eSpark-Backup/nabilfesal-efi-hw/README.md

# Earth Fault Indicator
#### Client Name: Nabil Fesal
