eSpark-Backup/nabilfesal-efi-hw/Design Files/EFI_Main_Board-V1.10/Deliverables/Renderings/3D-BottomView.png

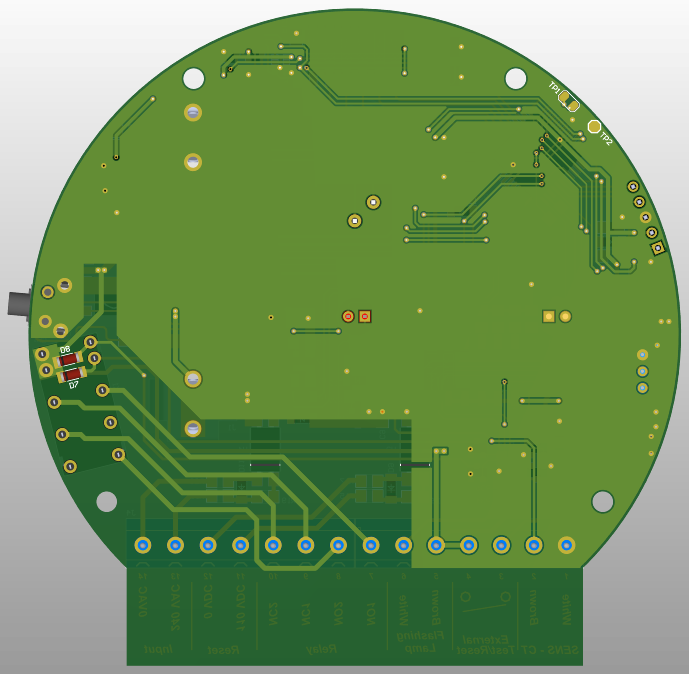
Design Files/EFI_Main_Board-V1.10/Deliverables/Renderings/3D-BottomView.png
