eSpark-Backup/nabilfesal-efi-hw/pics/Prototype/EFI_Main_Board-V1 (5).JPG

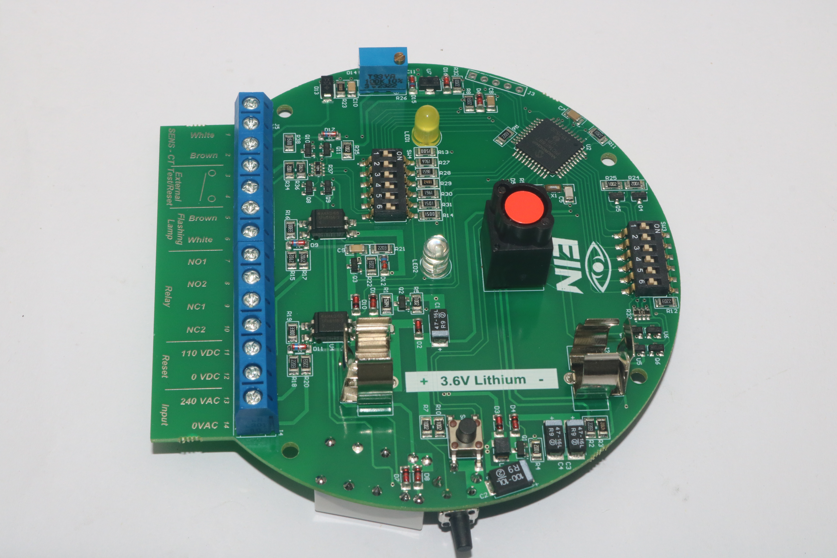
pics/Prototype/EFI_Main_Board-V1 (5).JPG
