eSpark-Backup/nabilfesal-efi-hw/pics/Prototype/EFI_Main_Board-V1 (6).JPG

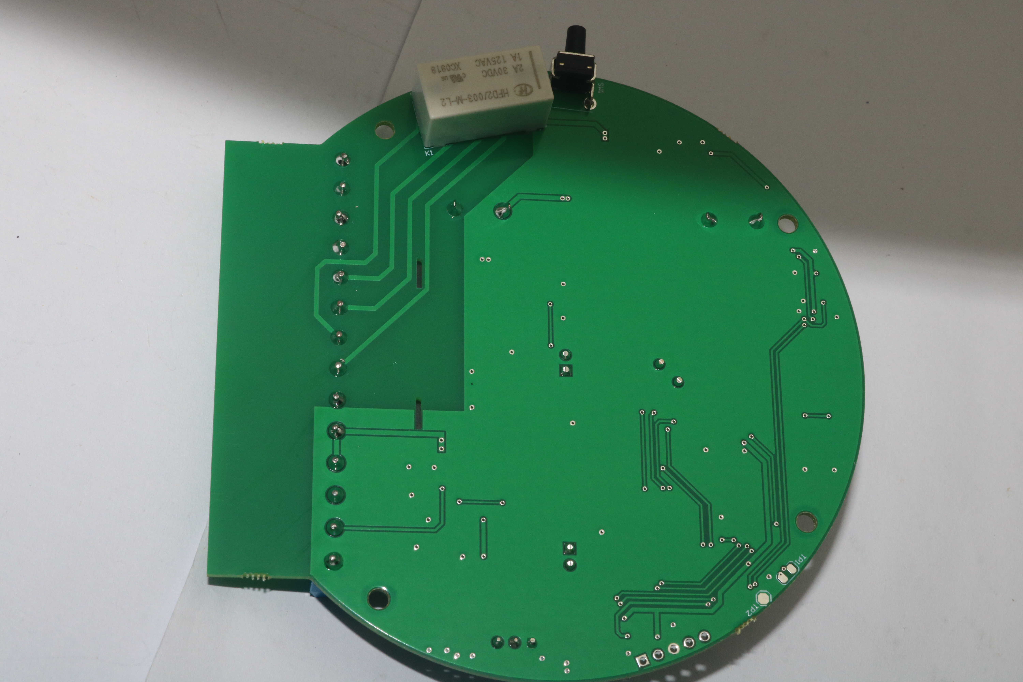
pics/Prototype/EFI_Main_Board-V1 (6).JPG
