eSpark-Backup/nabilfesal-efi-hw/pics/Prototype/EFI_Main_Board-V1 (10).JPG

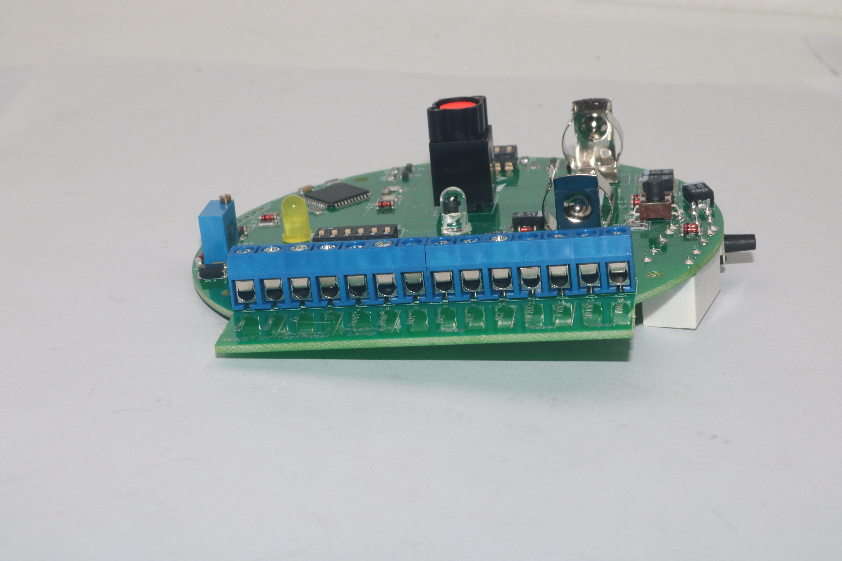
pics/Prototype/EFI_Main_Board-V1 (10).JPG
