eSpark-Backup/nabilfesal-efi-hw/Design Files/EFI_Main_Board-V1.10/BOM/Client_BOM_EFI_Main_Board-V1.10.xlsx

# | Item Type | Designator | Description | Footprint | Manufacturer Part Number | Manufacturer | Value | Quantity | Remarks
1 | Capacitors | C1, C3, C4 | CAP TANT 47UF 10% 16V 2312 | Case-C | 293D476X9016C2TE3 | Vishay Sprague | 47uF | 3
2 | Capacitors | C2 | CAP TANT 100UF 10% 10V 2917 | Case-D | 293D107X9010D2TE3 | Vishay Sprague | 100uF | 1
3 | Capacitors | C5, C6 | CAP CER 15PF 50V C0G/NPO 1206 | Cap-1206 | CC1206JRNPO9BN150 | Yageo | 15pF | 2
4 | Capacitor | C7, C8 | CAP CER 0.1UF 50V X7R 1206 | Cap-1206 | CC1206KRX7R9BB104 | Yageo | 0.1uF | 2
5 | Capacitor | C9, C10, C11 | CAP CER 0.047UF 100V X7R 1206 | Cap-1206 | CC1206JRX7R0BB473 | Yageo | 0.047uF | 3
6 | Schottky Diodes | D1, D2, D3, D4, D5, D6, D10, D16 | DIODE SCHOTTKY 40V 200MA SOD80 | LL-34 | LL103A-GS08 | Vishay | - | 8
7 | Diode | D7, D8 | 100V 1V@50mA 4ns 300mA LL-34 Switching Diodes ROHS | LL-34 | LL4148 | Yangzhou Yangjie Elec Tech | - | 2
8 | Diode | D9, D11 | Independent Type 2.5V~2.9V 500mW 2.7V LL-34 Zener Diodes ROHS | LL-34 | ZMM2V7 | HXY MOSFET | - | 2
9 | Diode | D12, D17 | Independent Type 500mW 3.4V~3.8V 3.6V LL-34 Zener Diodes ROHS | LL-34 | ZMM3V6 | HXY MOSFET | - | 2
10 | TVS Diodes | D13 | TVS DIODE 110VWM 177VC DO214AC | SMA Bi Directional | SMAJ110CA-E3/5A | Vishay | - | 1
11 | Rectifier Diodes | D14 | DIODE STANDARD 75V 150MA SOD80C | LL-34 | LL4448-GS08 | Vishay | - | 1
12 | Diode | D15 | Independent 4.8V~5.4V 500mW 5.1V LL-34 Single Zener Diodes RoHS | LL-34 | ZMM5V1 | HXY MOSFET | - | 1
13 | Battery Holder | J1, J2 | BATTERY CONTACT CLIP AA PC PIN | BK-92 | BK-92 | Memory Protection Devices | - | 2
14 | Screw Terminal | J4, J5 | 1x7P -40℃~+105℃ 15A 300V Blue 12~24 Direct Insert 5mm 1 7 Plugin,P=5mm Screw Terminal Blocks ROHS | Custom | JL301-50007U02 | JILN | - | 2
15 | Relay | K1 | Magnetic Latching Relays ROHS | Custom | AZ832P2-2C-3DE | ZETTLER | - | 1
16 | Inductors | L1 | FIXED IND 100UH 40MA 10 OHM SMD | Custom | NLV32T-101J-EF | TDK | 100uH | 1
17 | Magnetic Flag Indicator | L2 | Magnetic Status Indicator | Custom | 30NR | Flip Dots | 30NR | 1 | This part will be sourced from a custom supplier
18 | LED | LED1 | LED YELLOW DIFFUSED 5MM T/H | TH LED 5mm Yellow | 333-2UYD/S530-A3-L | Everlight | - | 1
19 | LEDs | LED2 | LED RED CLEAR 5MM ROUND T/H | TH LED 5mm_ | 333-2SURC/S530-A3 | Everlight | - | 1
20 | MOSFETs | Q1, Q2, Q6, Q7, Q8, Q9, Q10, Q11 | MOSFET BVDSS: 8V~24V SOT23 T&R 3 | SOT-23 | DMG3420UQ-7 | Diodes | - | 8
21 | BJTs | Q3 | TRANS NPN 45V 0.1A TO-236AB | SOT-23 | BC847C,215 | Nexperia | - | 1
22 | Transistors | Q4, Q5 | TRANS NPN 65V 0.1A SOT23-3 | SOT-23 | BC846B-7-F | Diodes | - | 2
23 | Resistors | R1 | RES SMD 60.4 OHM 1% 1/4W 1206 | Res-1206 | AC1206FR-0760R4L | Yageo | 60.4R | 1
24 | Resistors | R2, R6, R8, R9, R11, R12, R18, R20, R21, R22, R32 | RES SMD 220K OHM 0.1% 1/4W 1206 | Res-1206 | RT1206BRD07220KL | Yageo | 220K | 11
25 | Resistor | R3 | 250mW Thin Film Resistor 200V ±25ppm/℃ ±0.1% 47kΩ 1206 Chip Resistor - Surface Mount ROHS | Res-1206 | ARG06BTC4702 | Viking Tech | 47K | 1
26 | Resistors | R4, R5, R7, R10, R24, R25, R34, R35 | RES 10K OHM 1% 1/2W 1206 | Res-1206 | AC1206FR-7W10KL | Yageo | 10K | 8
27 | Resistor | R13, R14, R38 | 250mW Thick Film Resistors 200V ±100ppm/℃ ±1% 150Ω 1206 Chip Resistor - Surface Mount ROHS | Res-1206 | FRC1206F1500TS | FOJAN | 150R | 3
28 | Resistor | R15, R17 | 250mW Thick Film Resistors 200V ±100ppm/℃ ±1% 27kΩ 1206 Chip Resistor - Surface Mount ROHS | Res-1206 | FRC1206F2702TS | FOJAN | 27K | 2
29 | Resistor | R16, R19 | 250mW Thick Film Resistors 200V ±100ppm/℃ ±1% 330Ω 1206 Chip Resistor - Surface Mount ROHS | Res-1206 | FRC1206F3300TS | FOJAN | 330R | 2
30 | Resistors | R23 | RES SMD 22K OHM 0.1% 1/4W 1206 | Res-1206 | RT1206BRD0722KL | Yageo Group | 22K | 1
31 | Potensiometer | R26 | TRIMMER 100K OHM 0.5W PC PIN TOP | Custom | T93YA104KT20 | Vishay Sfernice | 100K | 1
32 | Resistors | R27 | RES SMD 5.62K OHM 0.1% 1/4W 1206 | Res-1206 | RT1206BRD075K62L | Yageo Group | 5.62K | 1
33 | Resistors | R28 | RES SMD 2.4K OHM 0.1% 1/4W 1206 | Res-1206 | RT1206BRD072K4L | Yageo Group | 2.4K | 1
34 | Resistors | R29 | RES SMD 1.54K OHM 0.1% 1/4W 1206 | Res-1206 | RT1206BRD071K54L | Yageo Group | 1.54K | 1
35 | Resistors | R30 | RES SMD 1.15K OHM 0.1% 1/4W 1206 | Res-1206 | RT1206BRD071K15L | Yageo Group | 1.15K | 1
36 | Resistors | R31 | RES 800 OHM 0.1% 1/4W 1206 | Res-1206 | MCA12060D8000BP500 | Vishay | 800R | 1
37 | Resistor | R33 | 4 ±5% 10kΩ 62.5mW ±200ppm/℃ 0603x4 Resistor Networks, Arrays ROHS | 0603x4 | 4D03WGJ0103T5E | Royal Electronic Factory | 10K | 1
38 | Resistor | R36 | 250mW Thick Film Resistors 200V ±100ppm/℃ ±1% 47Ω 1206 Chip Resistor - Surface Mount ROHS | Res-1206 | FRC1206F47R0TS | FOJAN | 47R | 1
39 | Resistor | R37 | RES ARRAY 4 RES 100K OHM 1206 | Custom | YC164-JR-07100KL | Yageo | 100K | 1
40 | Tactile Switch | SW1 | 50mA Lying SPST 24V Plugin Tactile Switches ROHS | Custom | 1825027-8 | TE Connectivity | - | 1
41 | Switches | SW2 | SWITCH TACTILE SPST-NO 0.05A 24V | Custom | FSM6JSMATR | TE Connectivity Alcoswitch | - | 1
42 | DIP SWITCH | SW3, SW4 | 6 digits 24V Black 25mA 3000 Times SMD DIP Switches ROHS | Custom | SMXS-06K-TP | SM Switch | - | 2
43 | IC | U1 | Supervisory Circuits | SOT-89-3 | XC61CC2502PR-G | Torex | - | 1
44 | IC | U2 | IC MCU 8BIT 14KB FLASH 44TQFP | 44-TQFP (10x10) | PIC16F887-I/PT | Microchip | - | 1
45 | IC | U3, U4 | OPTOISOLATOR 5.3KV TRANS 4SMD | Custom | SFH6156-2 | Vishay | - | 2
46 | MOSFETs | U5, U6 | MOSFET P-CH 20V 4.2A SOT23-3 | SOT-23 | DMP2305U-7 | Diodes Zetex | - | 2
47 | IC | U7 | Supervisory Circuits | SOT-89-3 | XC61CC3002PR-G | Torex | - | 1
48 | Crystals | X1 | 32.768kHz Surface Mount Crystal 12.5pF ±20ppm SMD3215-2P Crystals ROHS | SMD3215-2P | Q13FC13500004 | Epson | - | 1
49 | Peripheral | Battery | BATTERY LITHIUM 3.6V AA | Custom | LS14500 | Saft | - | 1
50 | Peripheral | CT | Split core Ground fault protection current transformer | Custom | LO-CTK1503203 | WUXI LIOU ELECTRONICS CO.,LTD | - | 1 | This part will be sourced from a custom supplier
