eSpark-Backup/nabilfesal-efi-hw/Design Files/EFI_Main_Board-V1.10/Deliverables/Supporting Files/EFI.step

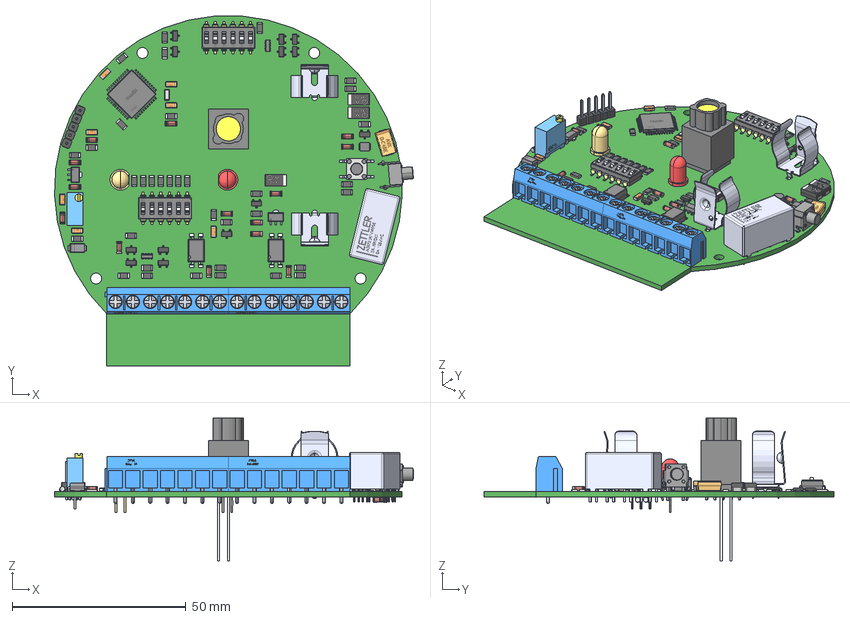
[picture p17: CAD file, 2025-08-29]
Design Files/EFI_Main_Board-V1.10/Deliverables/Supporting Files/EFI.step
103.3 x 100.7 x 41.0 mm
FSM6JSMATR--3DModel-STEP-510211
User Library-LED-D5R
30nr status indicator
User Library-NDK_NX3215SA
User_Library_SOT89_5005 x 2
CircuitWorks-SOT-23 x 13
c-1825027-8-h-3d_RGB6710886
User Library-CR3216-1206 x 35
YC164-JR-070RL
TC164-JR-070RL
User Library-LED-D5R_RGB6740479
AZ832P2-2C-3DE
CircuitWorks-HEADER 2_54 VERTICAL 5X
BK-92 x 2
User Library-DO-214AC SMA
User Library-1206 SMD Capacitor x 7
C-CASE x 3
User Library-AVX_D_CASE
