eSpark-Backup/nabilfesal-efi-hw/Enclosure-Files/Fault Indicator Ard - X-20251015T050849Z-1-001/Fault Indicator Ard - X/Fault Indicator Ard - X V1.1 220925/Fault Indicator Ard - X CAD Model 220925/Fault Indicator Ard-X_22092025 3D CAD Model.STEP

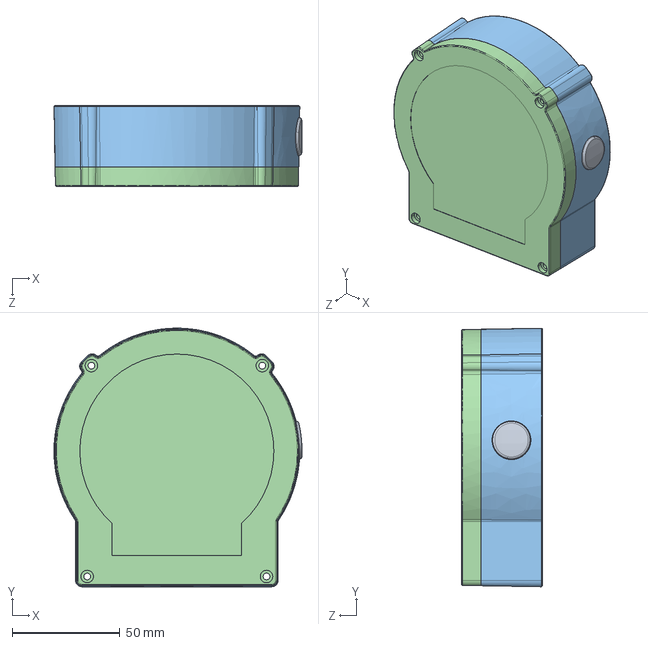
[picture p18: CAD file, 2025-10-16]
Enclosure-Files/Fault Indicator Ard - X-20251015T050849Z-1-001/Fault Indicator Ard - X/Fault Indicator Ard - X V1.1 220925/Fault Indicator Ard - X CAD Model 220925/Fault Indicator Ard-X_22092025 3D C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
115.0 x 119.9 x 37.4 mm
