eSpark-Backup/nabilfesal-efi-hw/(list of files, cad)

Other CAD files:
Design Files/EFI_Main_Board-V1.00/Deliverables/Supporting Files/EFI.step
Design Files/EFI_Main_Board-V1.00/Deliverables/Supporting Files/EFI.DWG
Design Files/EFI_Main_Board-V1.00/Deliverables/Supporting Files/EFI.DXF
Design Files/EFI_Main_Board-V1.10/Deliverables/Supporting Files/EFI.DWG
Design Files/EFI_Main_Board-V1.10/Deliverables/Supporting Files/EFI.DXF
