eSpark-Backup/nabilfesal-efi-hw/Design Files/EFI_Main_Board-V1.10/Schematics/EFI_Main_Board-V1.10.pdf

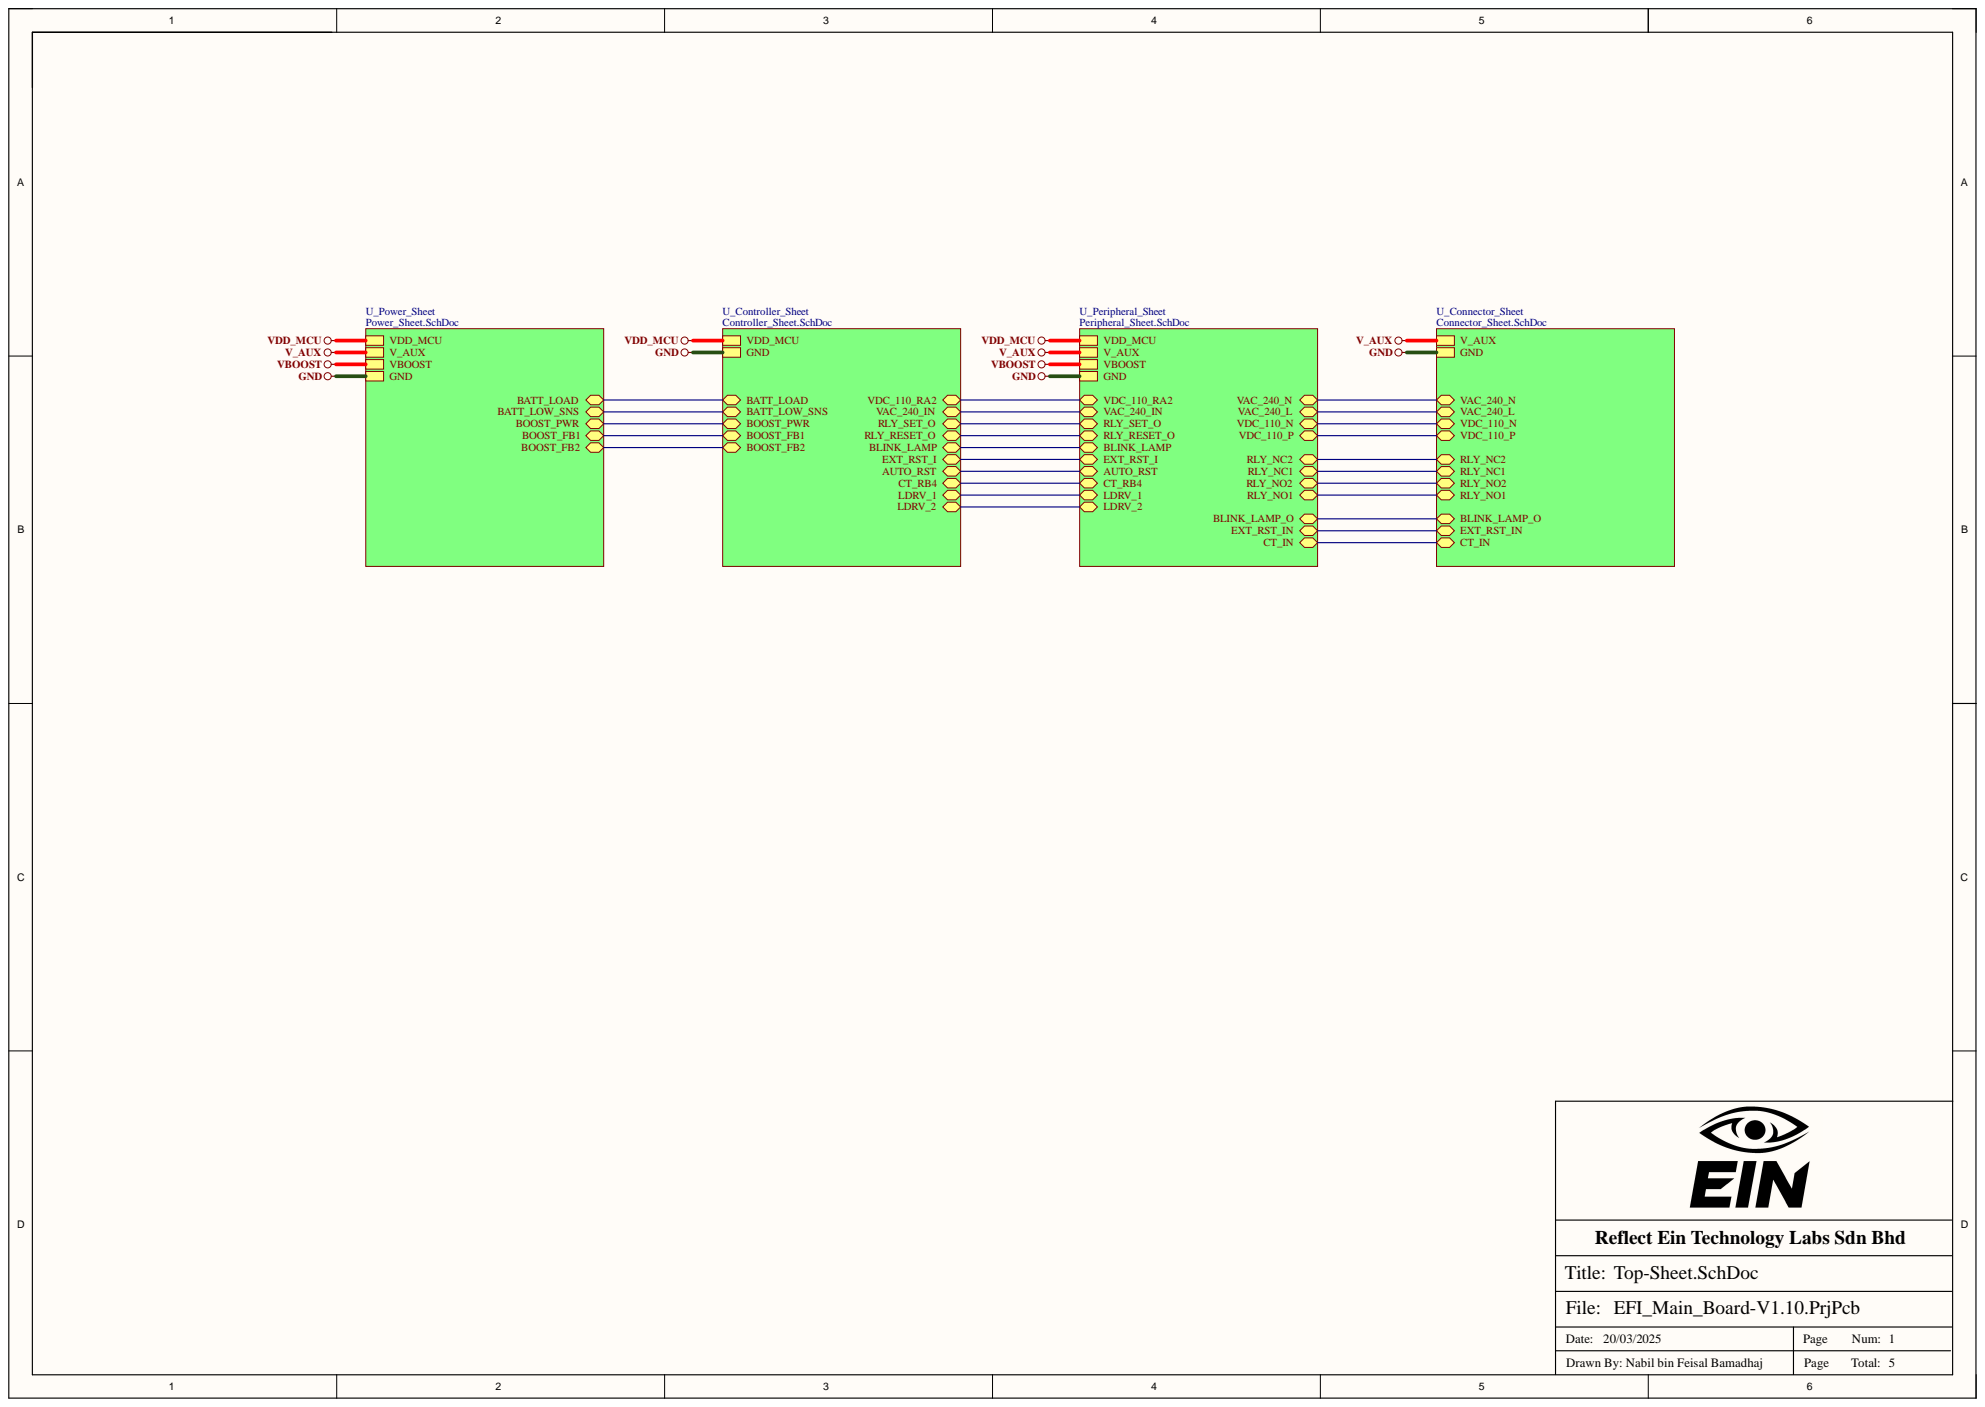
[picture p19: page 1]

Reflect Ein Technology Labs Sdn Bhd

Date: 20/03/2025 | Page Num: 1

Drawn By: Nabil bin Feisal Bamadhaj | Total:

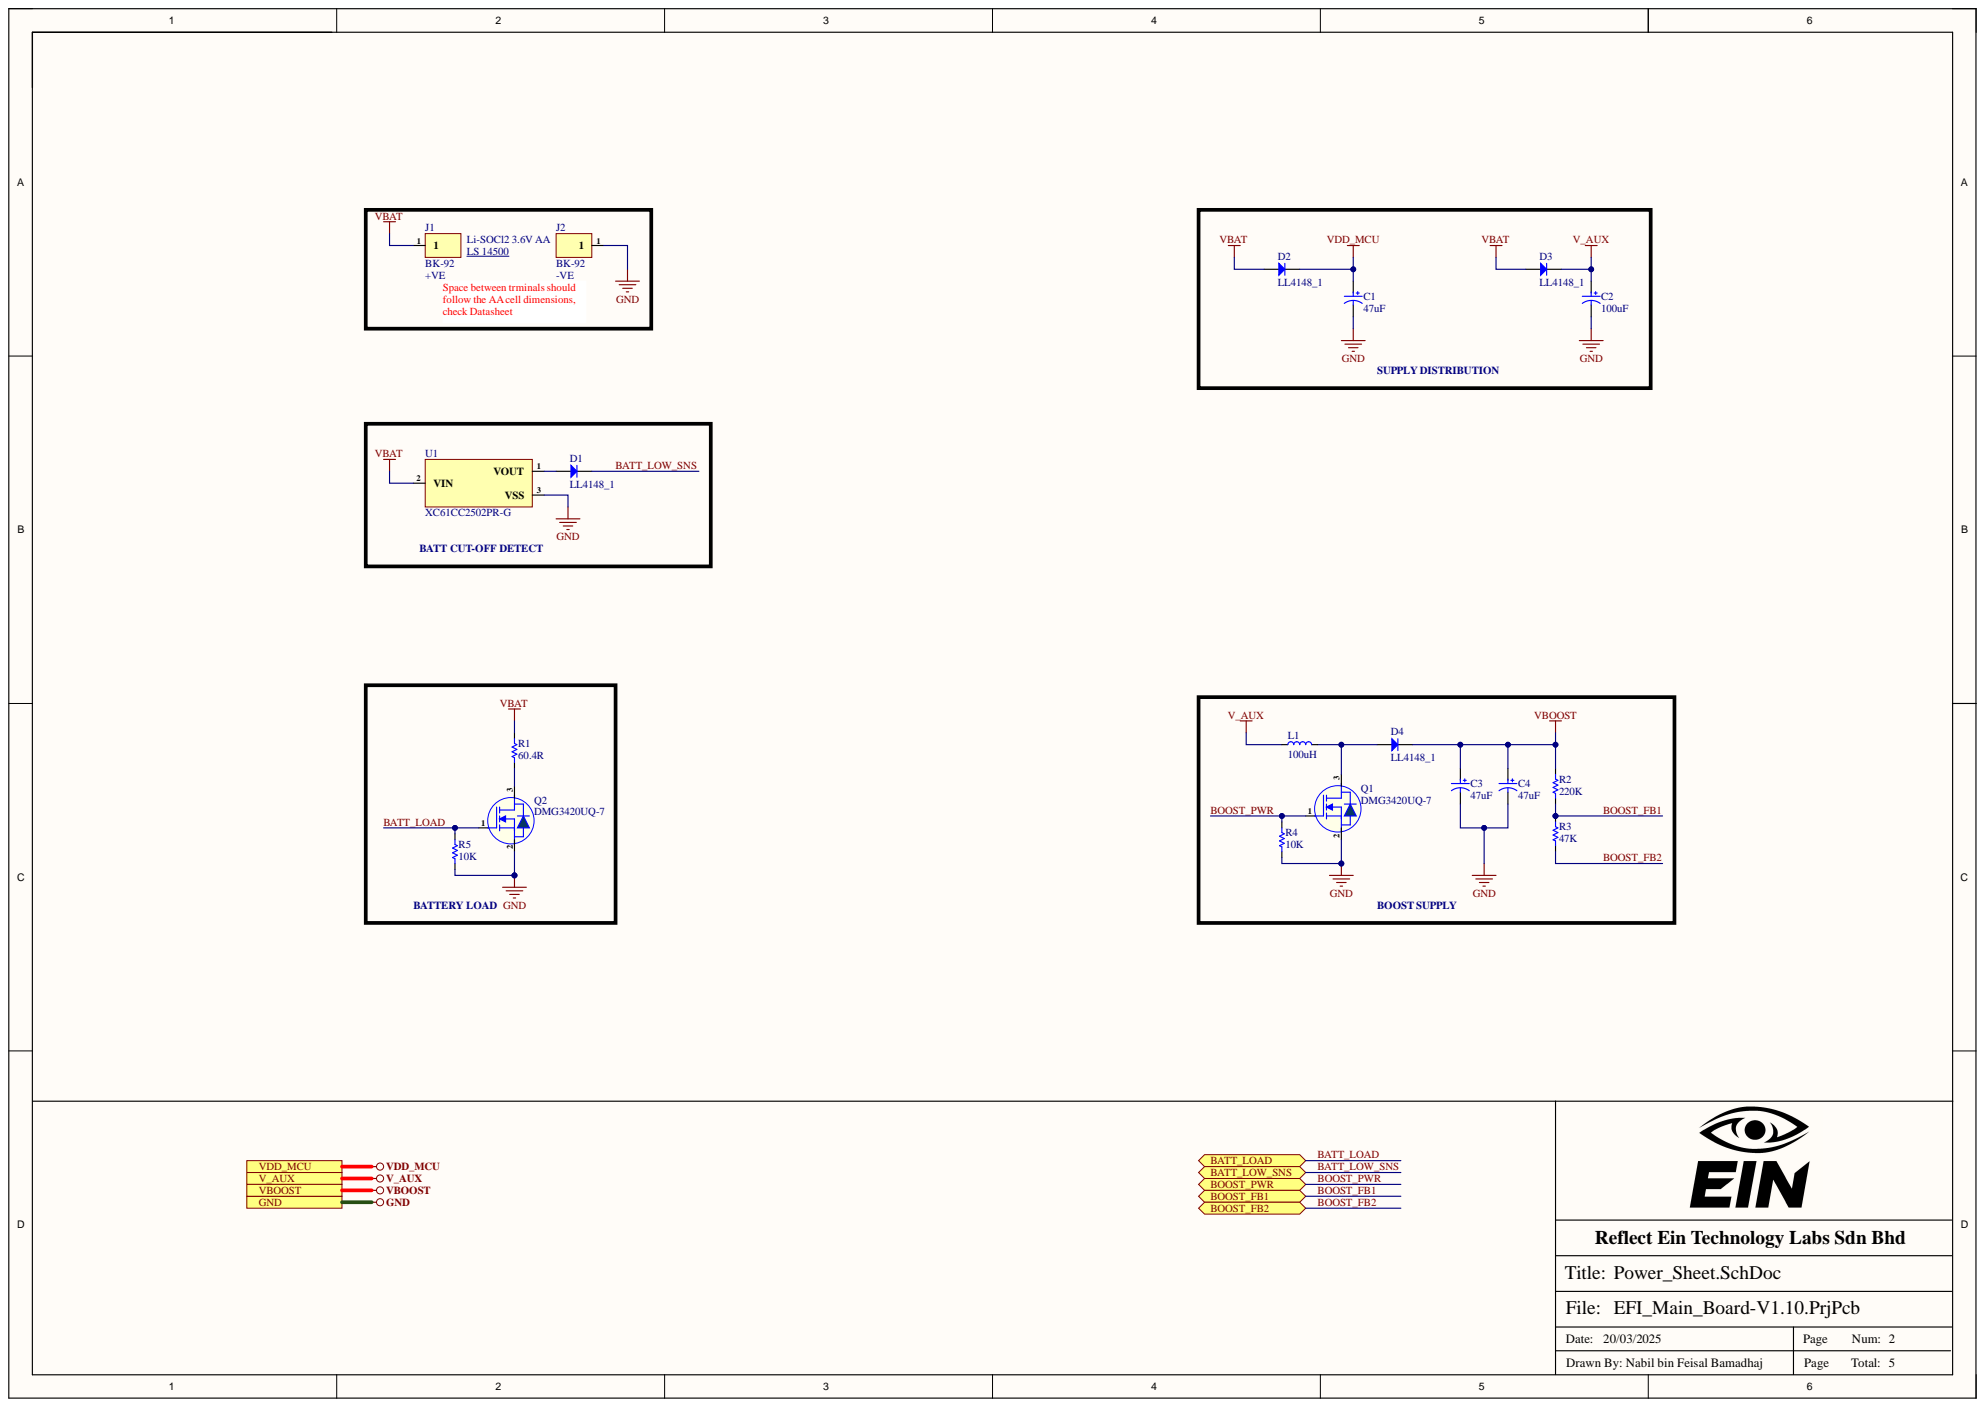
[picture p20: page 2]

Space between trminals should
follow the AAcell dimensions,
check Datasheet

BATT CUT-OFF DETECT

Reflect Ein Technology Labs Sdn Bhd

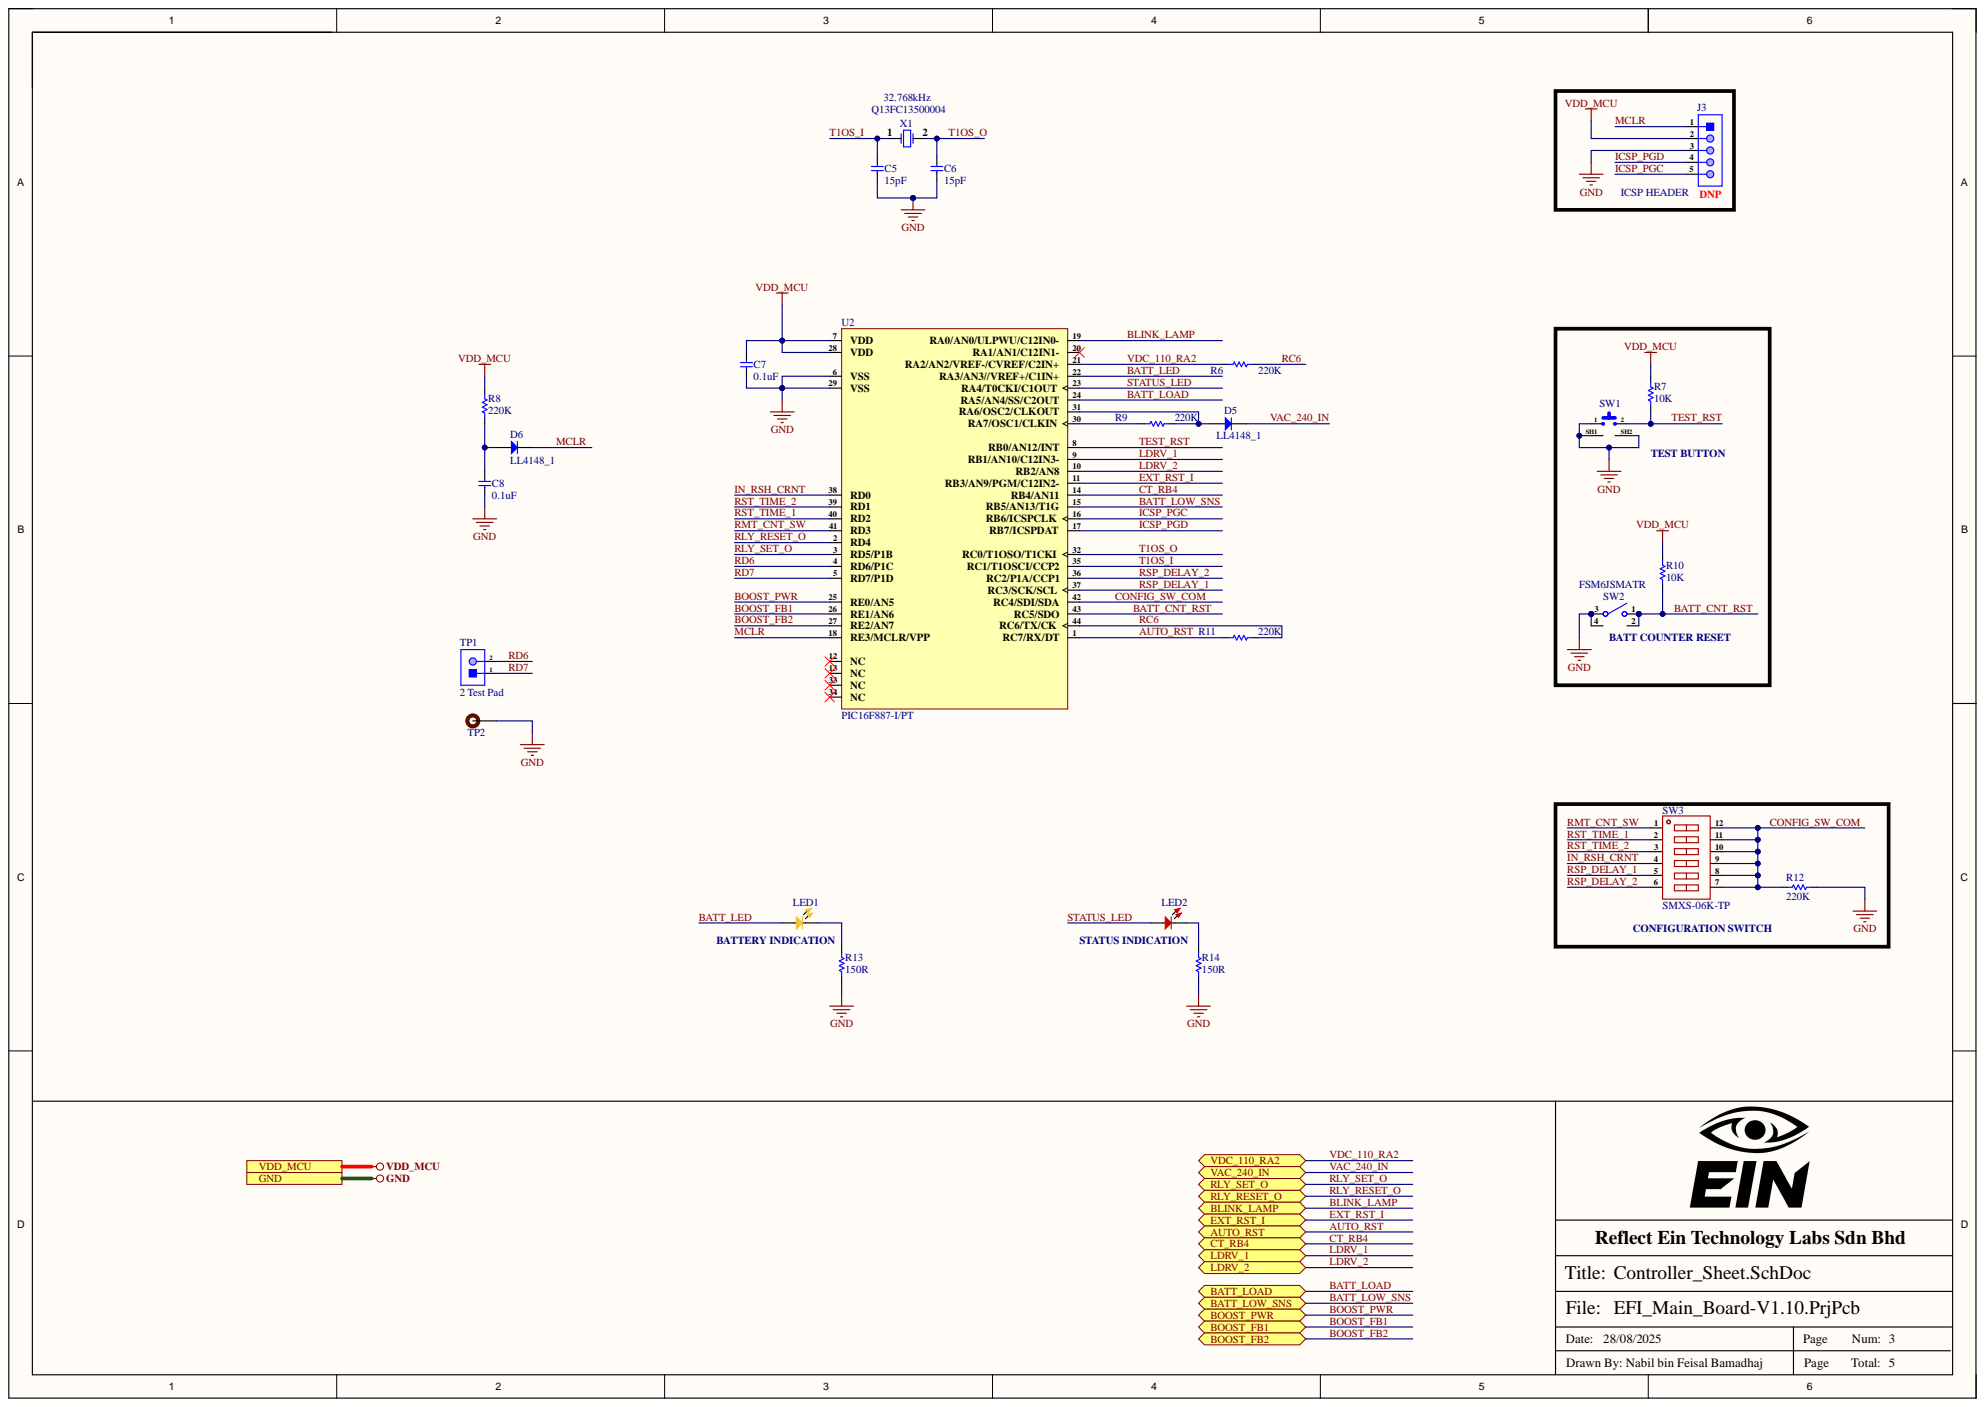
[picture p21: page 3]

Reflect Ein Technology Labs Sdn Bhd

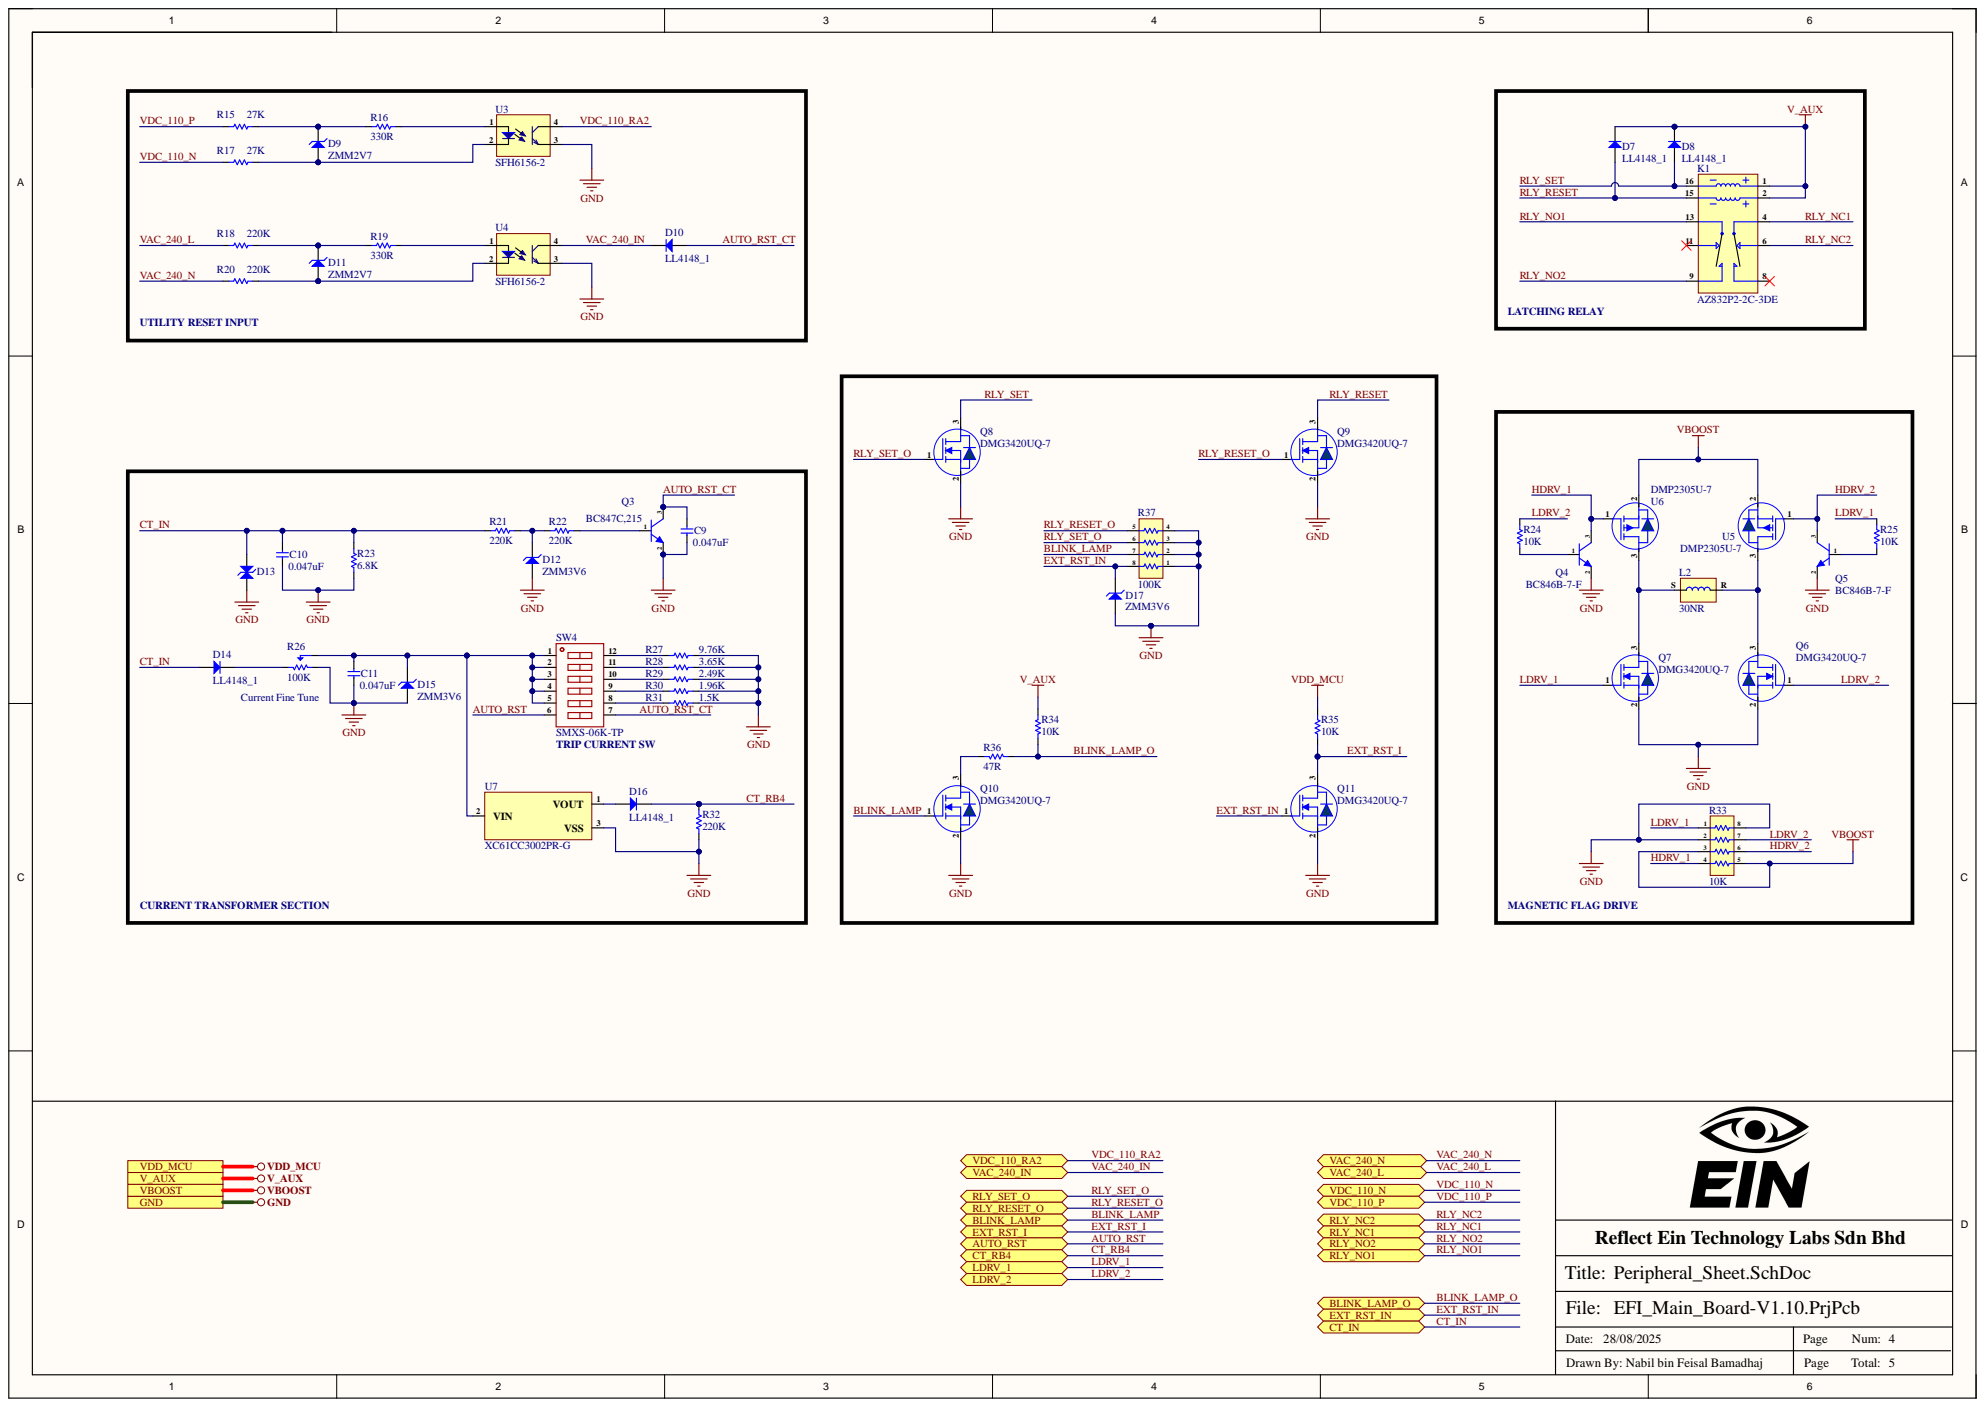
[picture p22: page 4]

3 6 | HDRV_2

HDRV_1

Reflect Ein Technology Labs Sdn Bhd

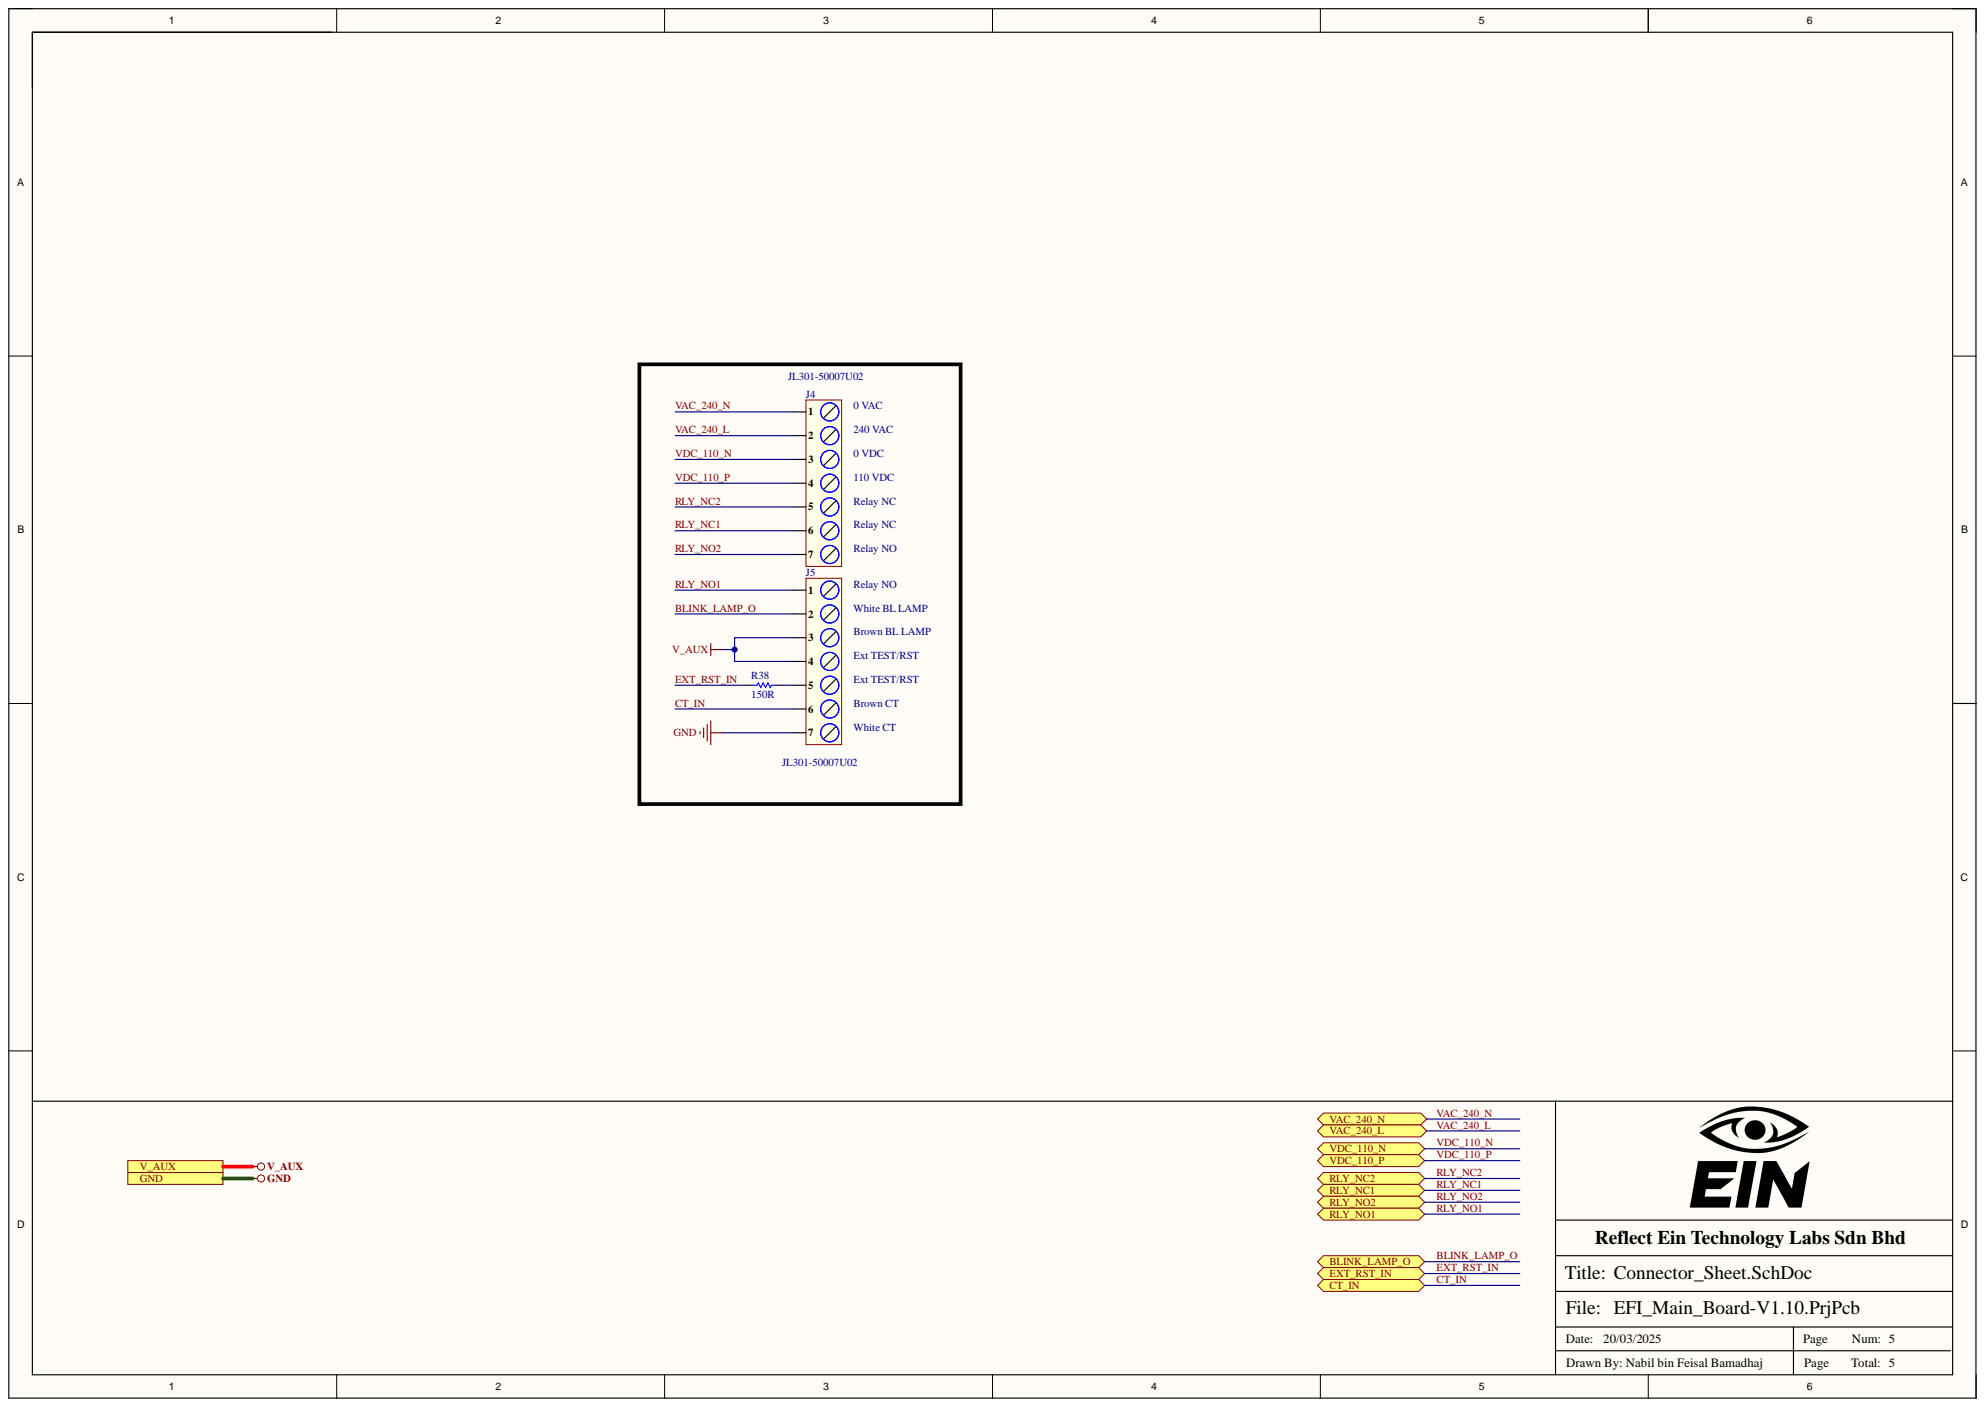
[picture p23: page 5]

Reflect Ein Technology Labs Sdn Bhd
