eSpark-Backup/nabilfesal-efi-hw/Design Files/EFI_Main_Board-V1.00/Schematics/EFI_Main_Board-V1.00.pdf

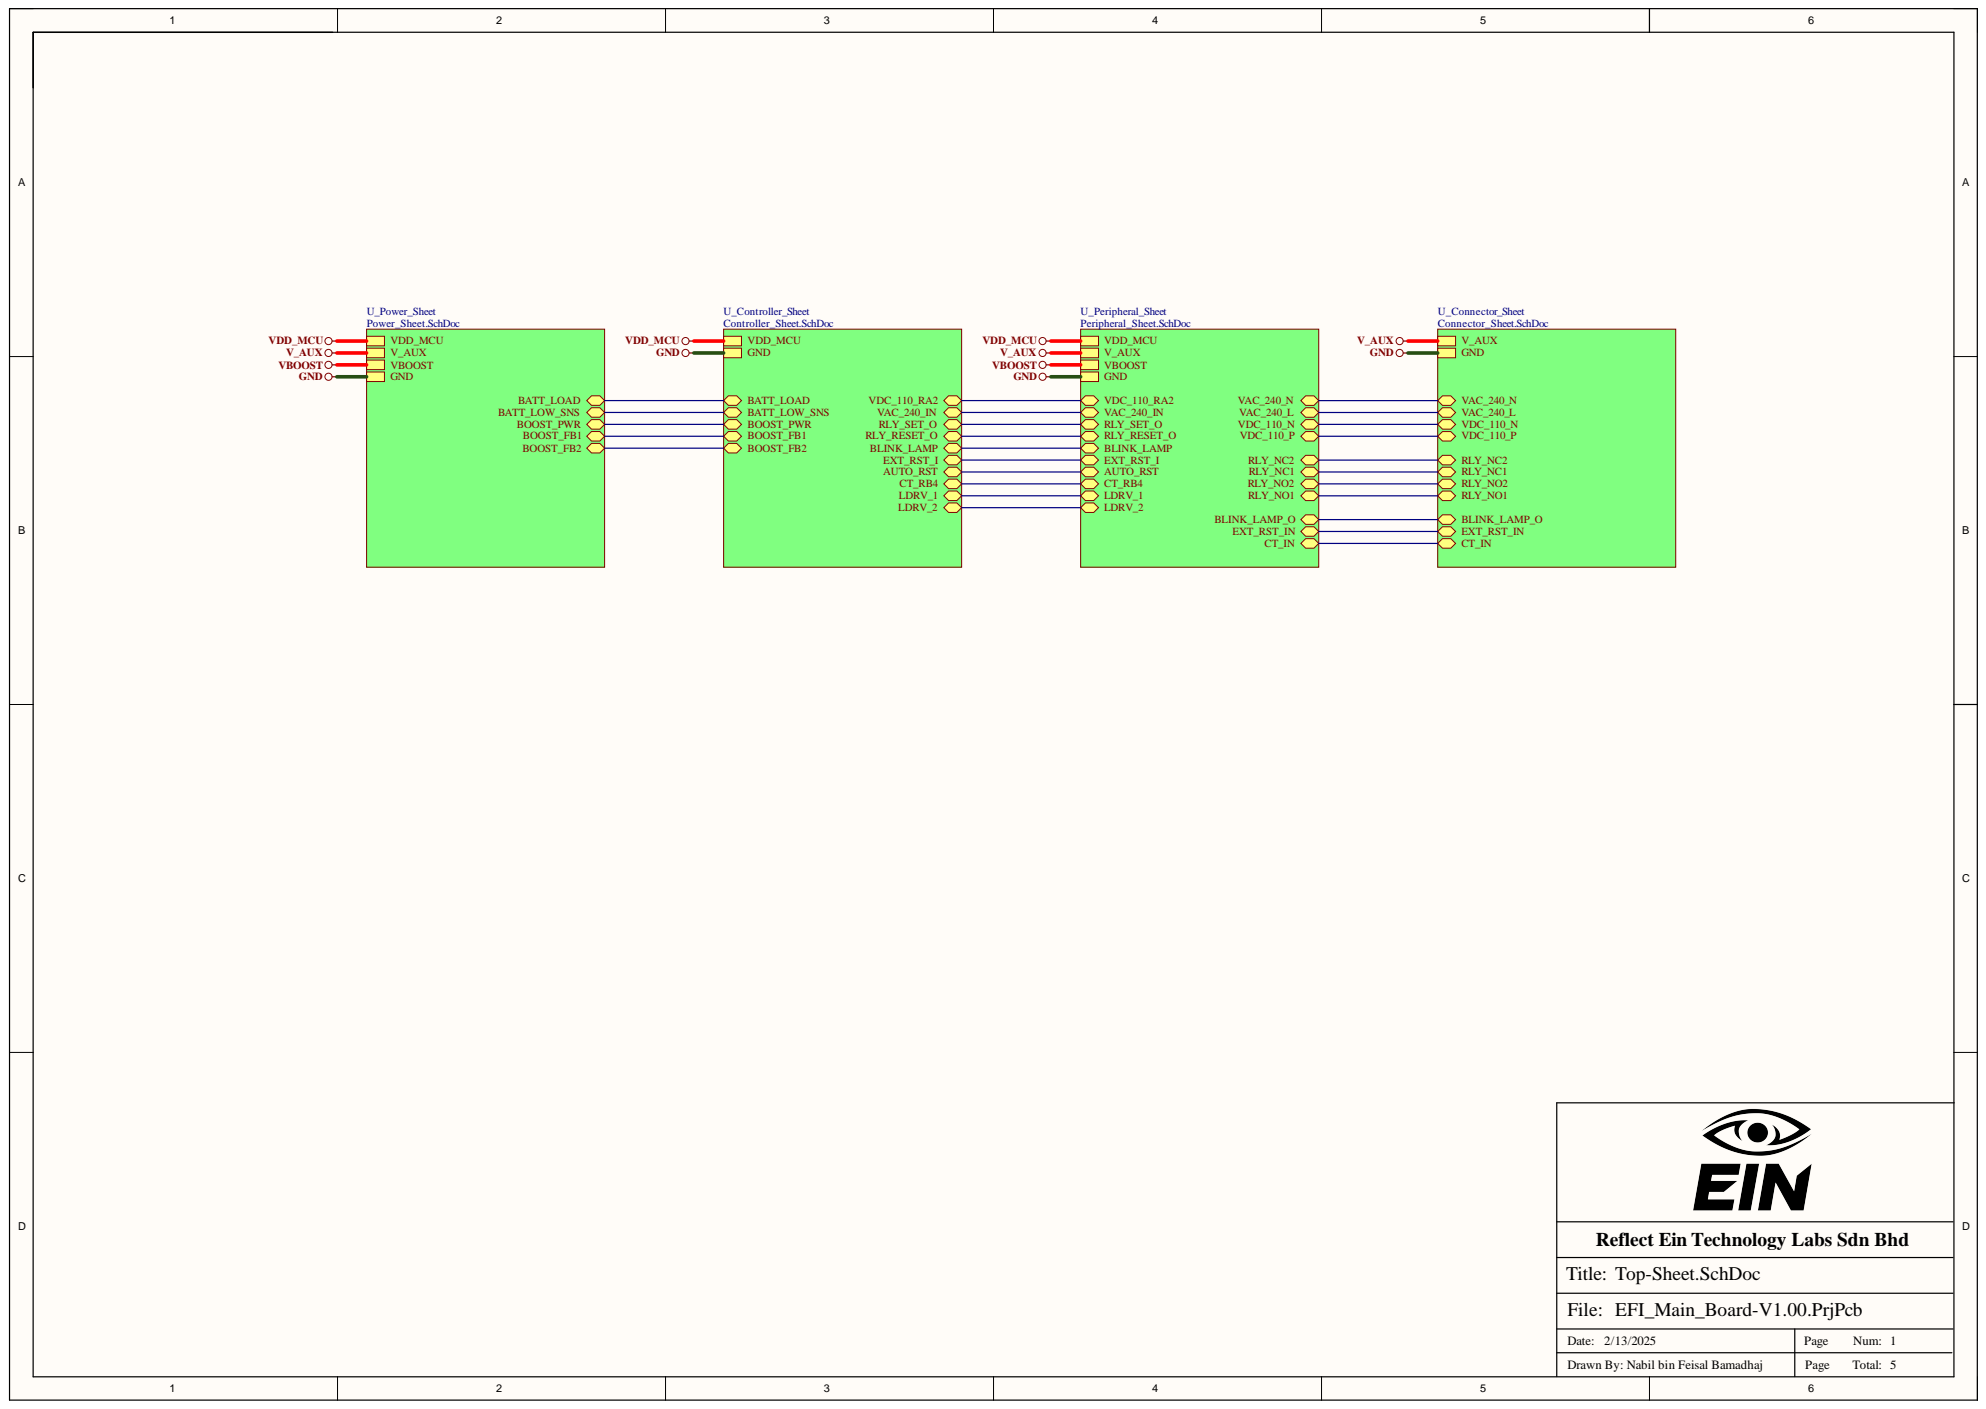
[picture p24: page 1]

Reflect Ein Technology Labs Sdn Bhd

Date: 2/13/2025 | Page Num: 1

Drawn By: Nabil bin Feisal Bamadhaj | Page Total:

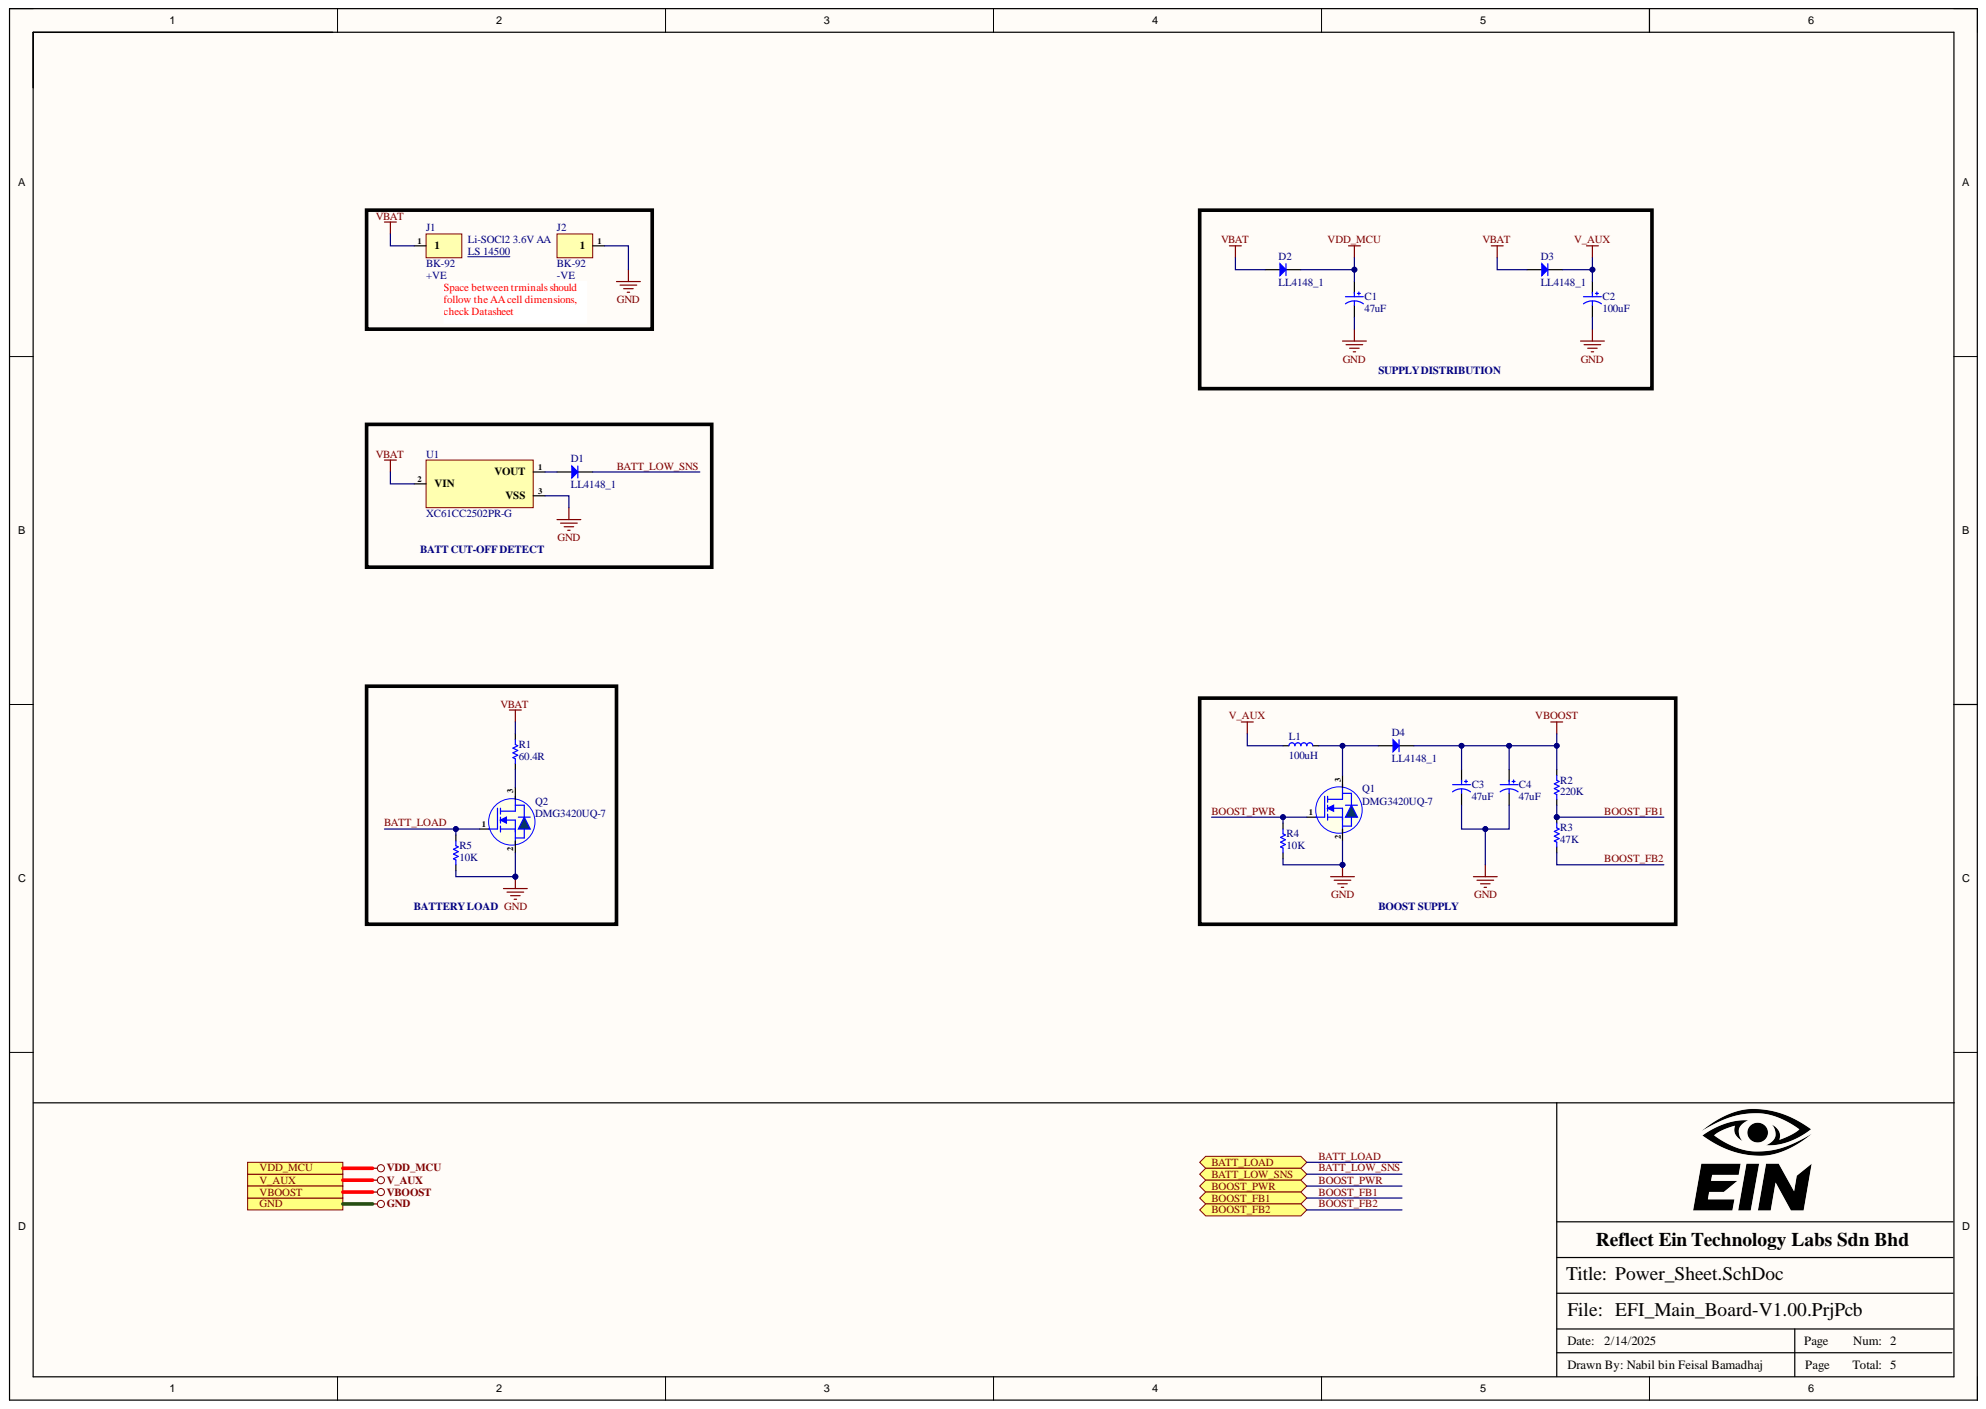
[picture p25: page 2]

Space between trminals should
follow the AAcell dimensions,
check Datasheet

BATT CUT-OFF DETECT

Reflect Ein Technology Labs Sdn Bhd

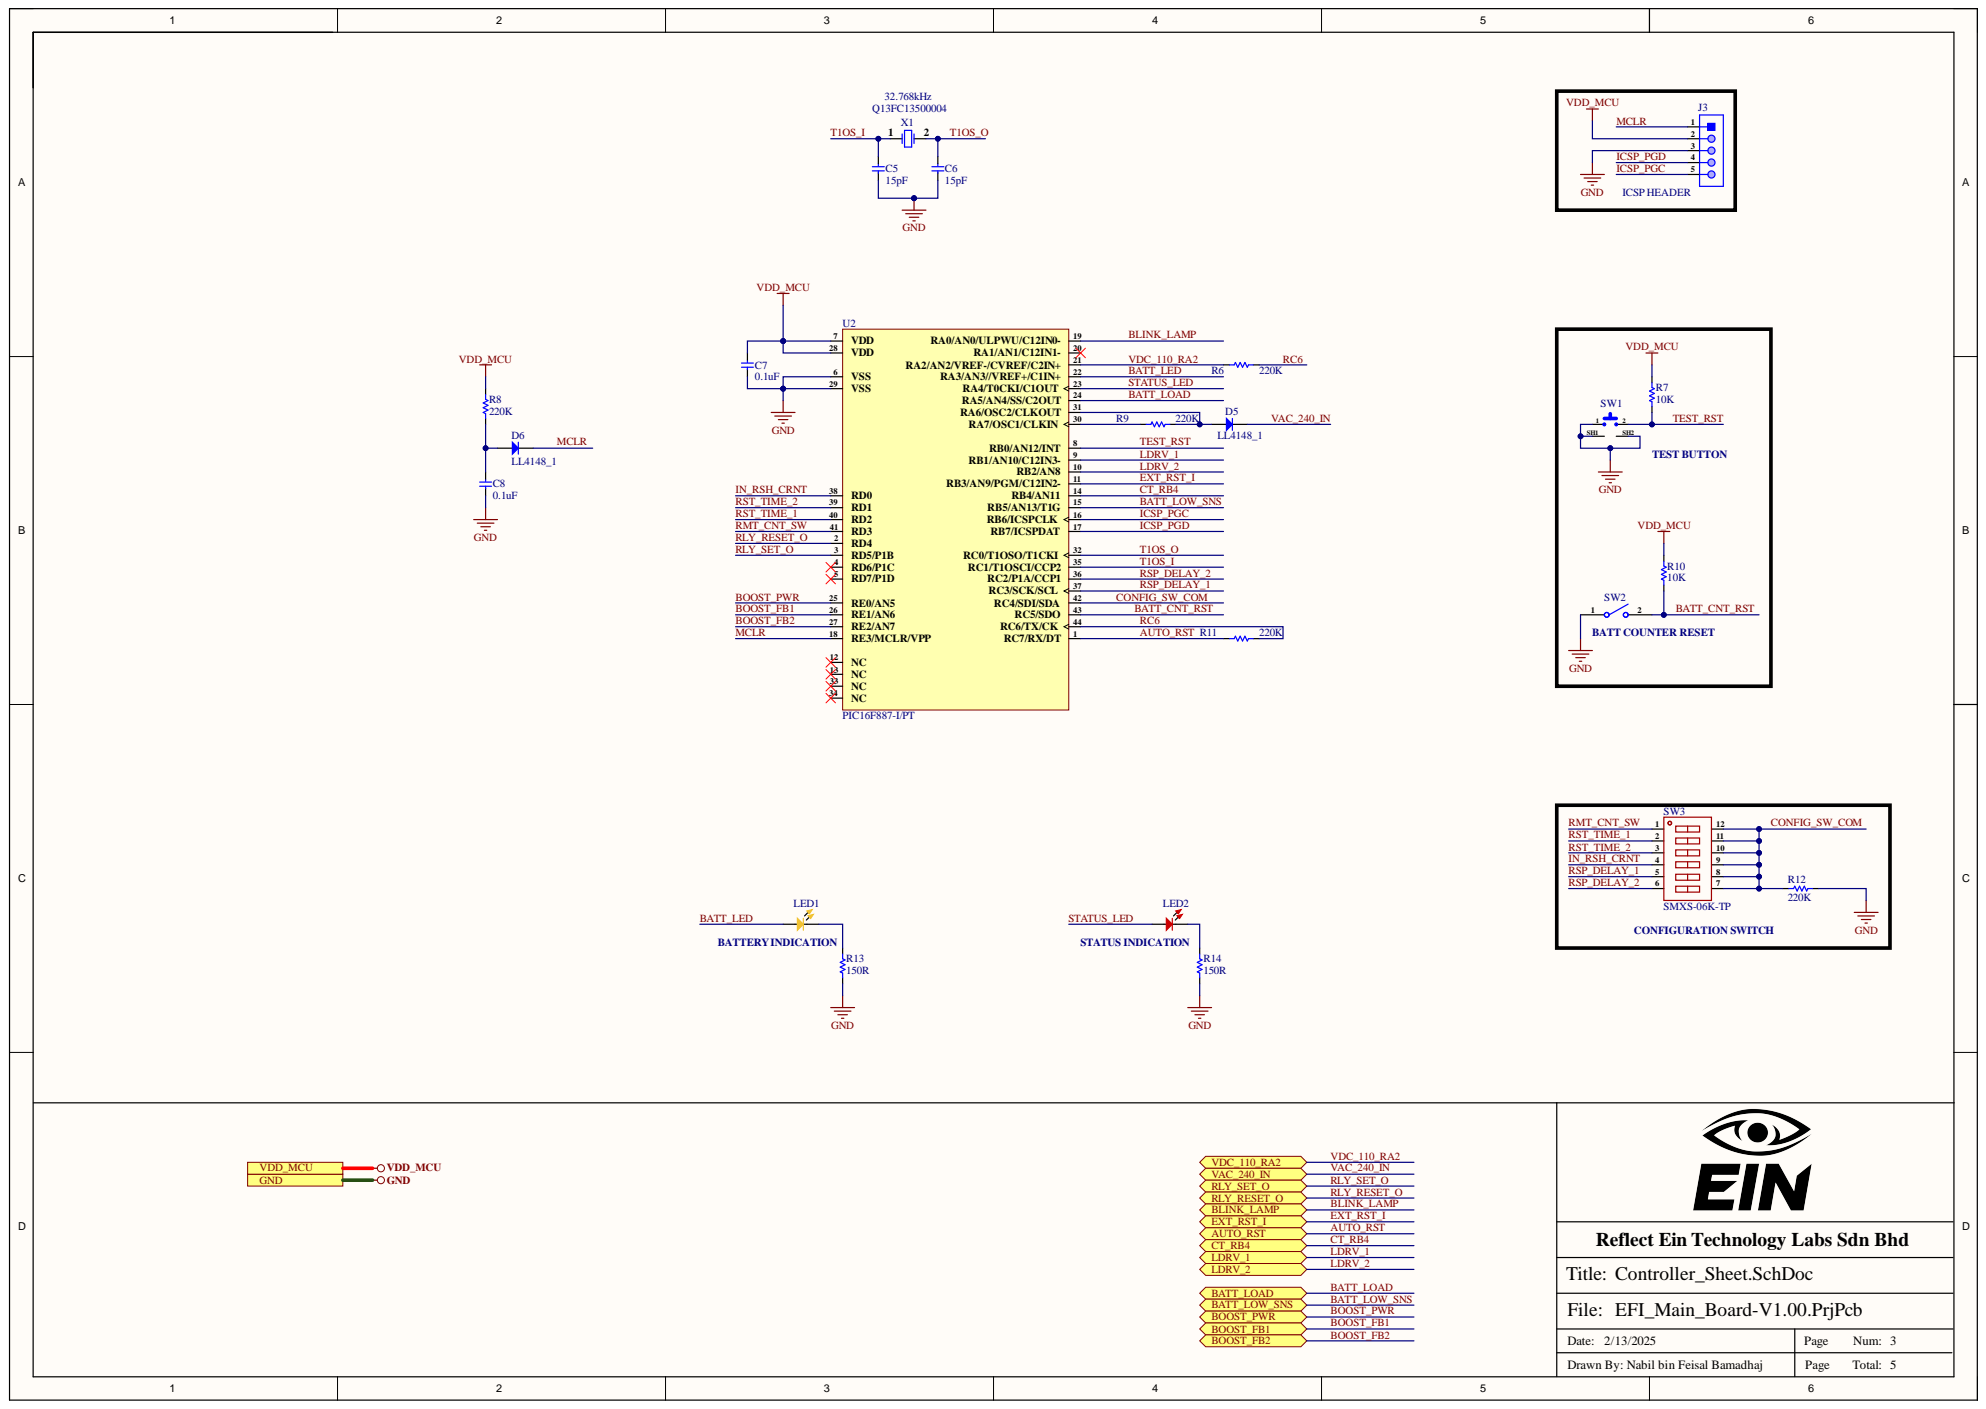
[picture p26: page 3]

Reflect Ein Technology Labs Sdn Bhd

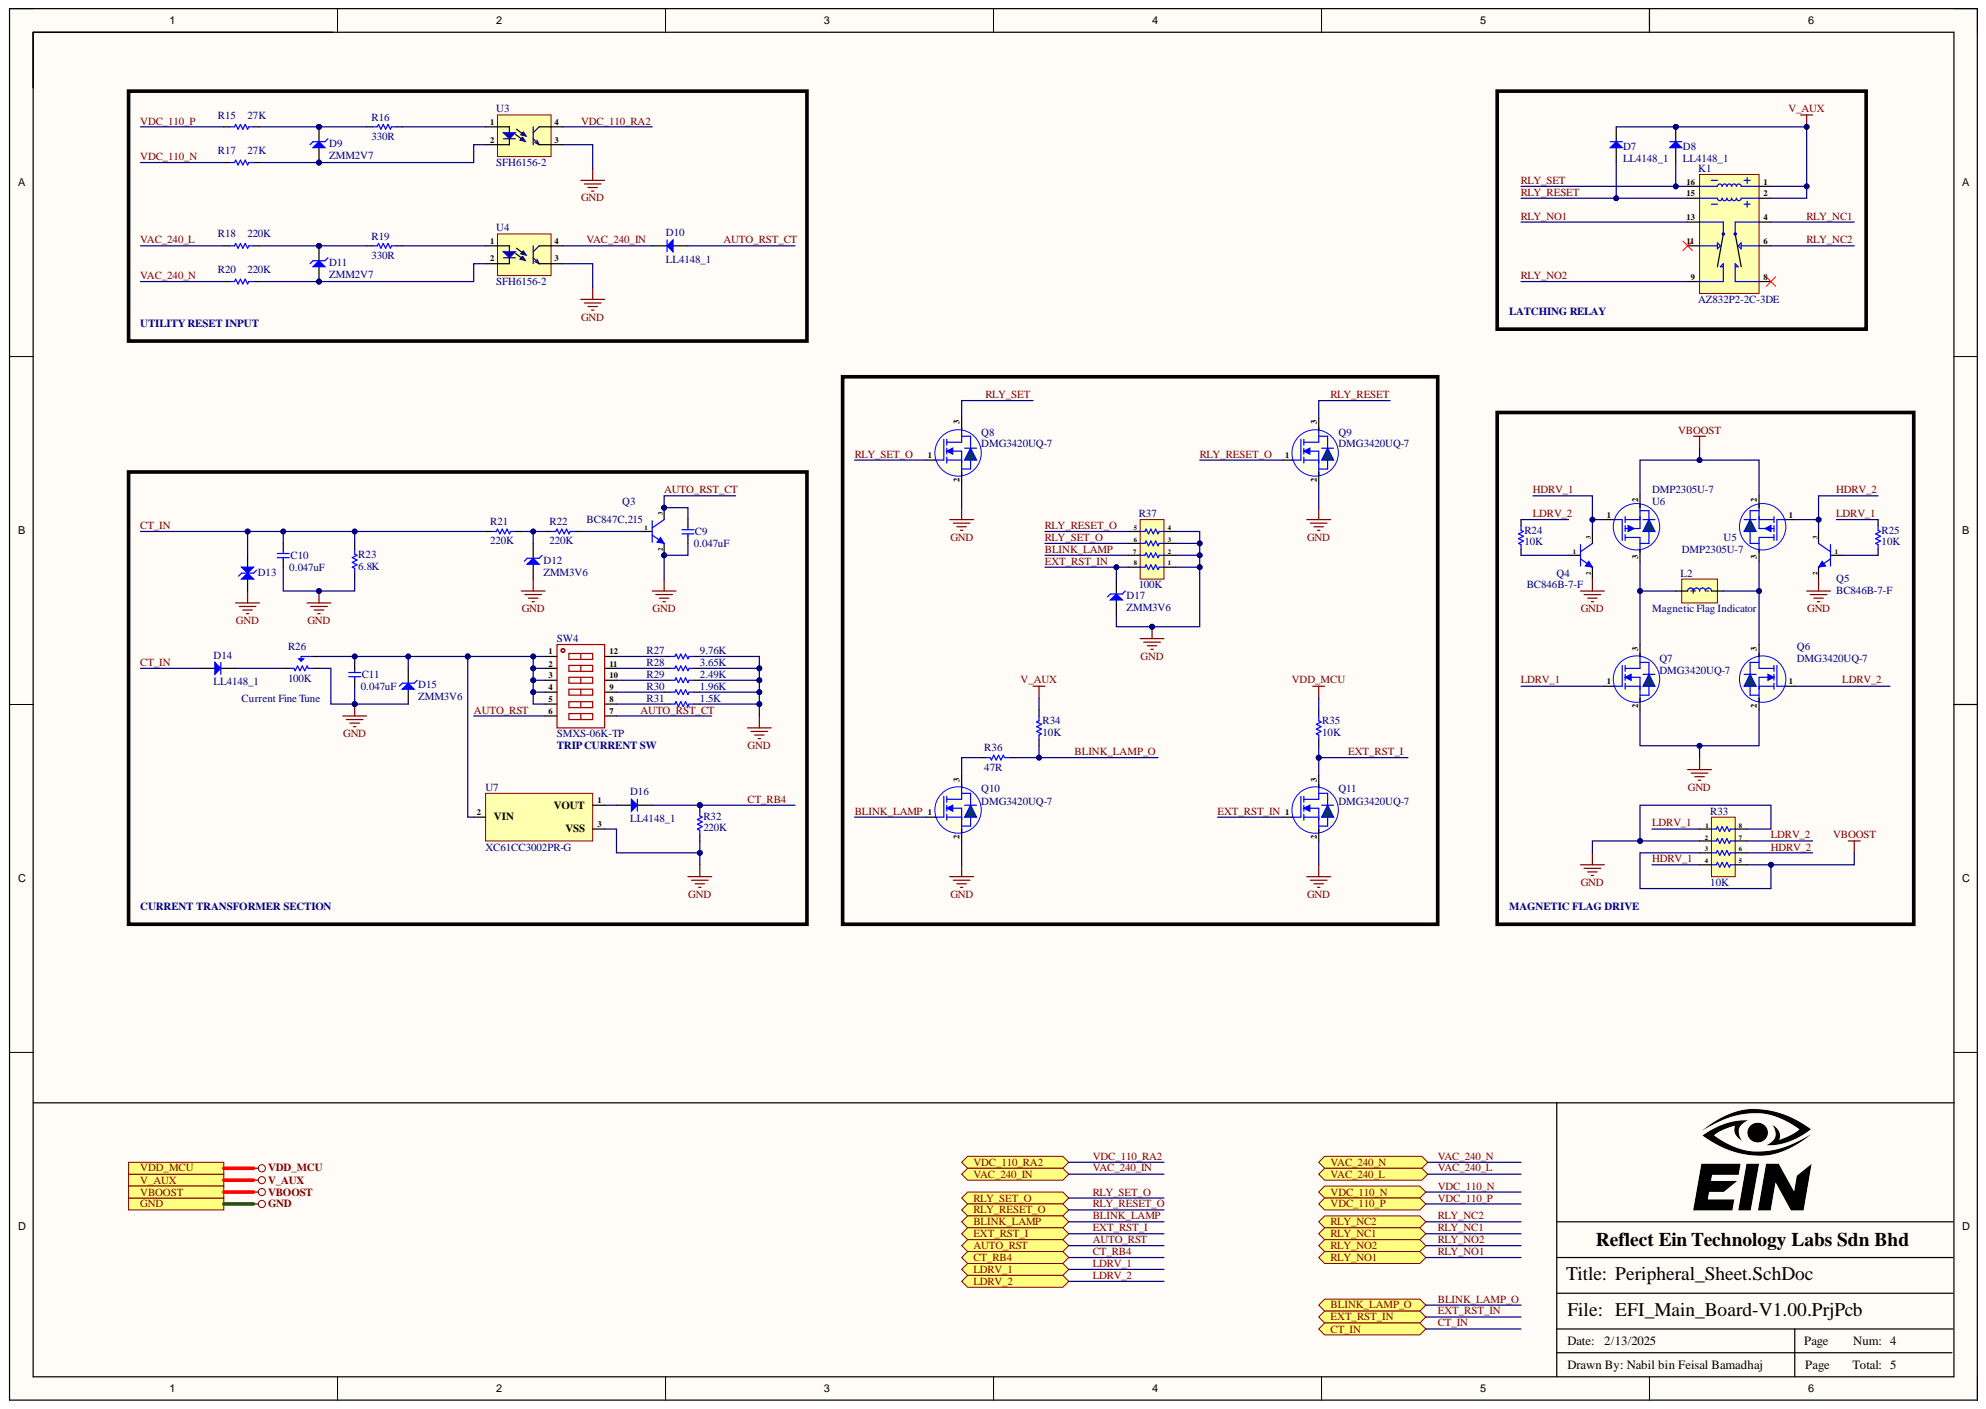
[picture p27: page 4]

Reflect Ein Technology Labs Sdn Bhd

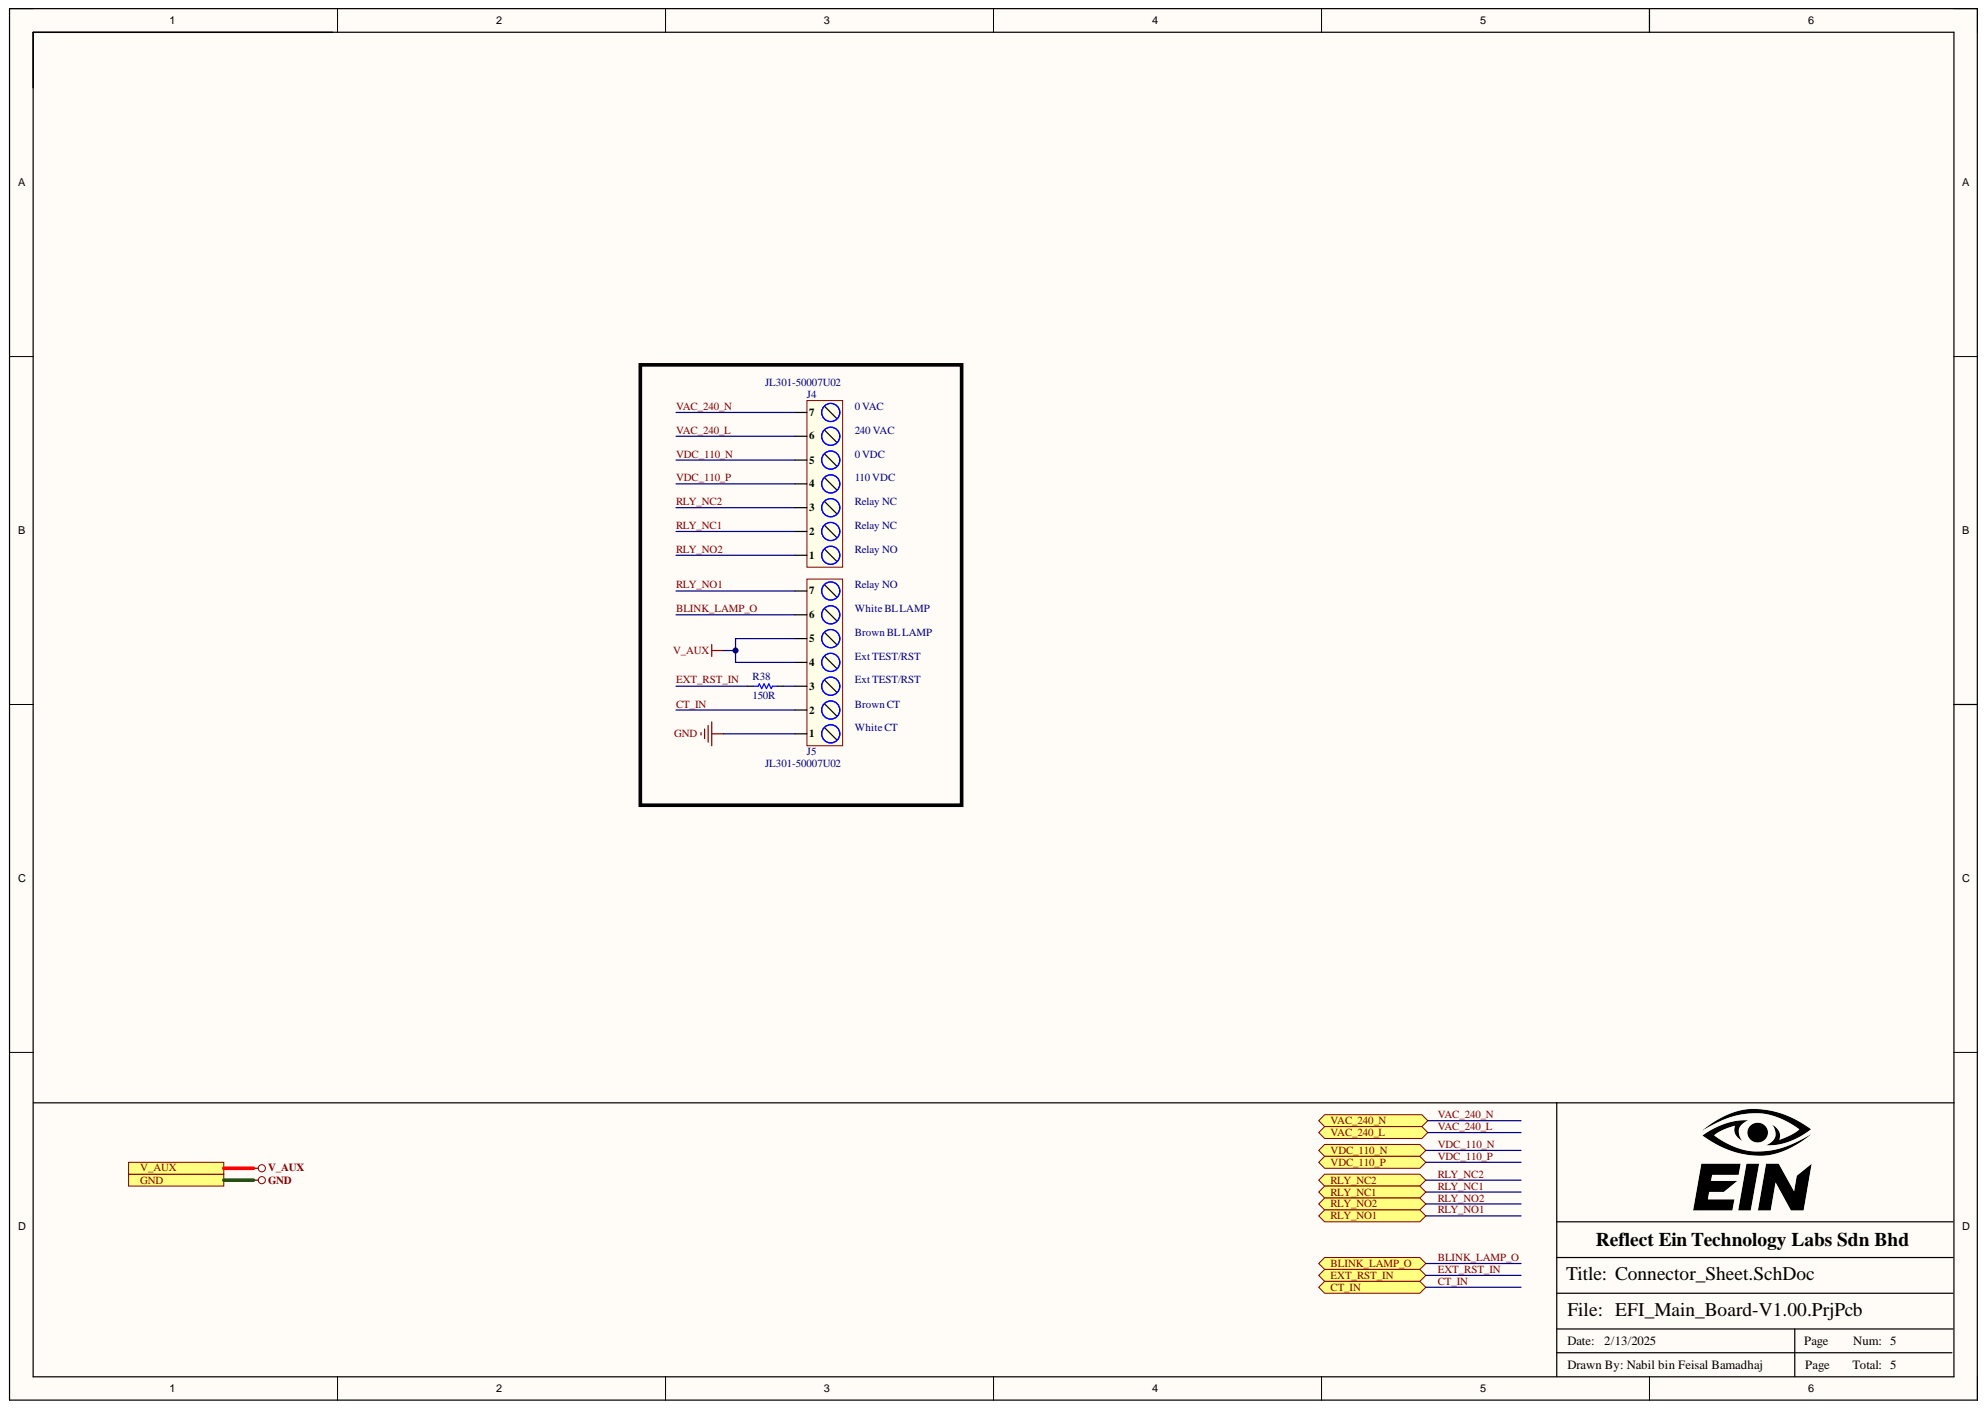
[picture p28: page 5]

Reflect Ein Technology Labs Sdn Bhd
