eSpark-Backup/nabilfesal-efi-hw/Design Files/EFI_Main_Board-V1.00/Deliverables/Assembly Drawings/Assembly Drawing.pdf

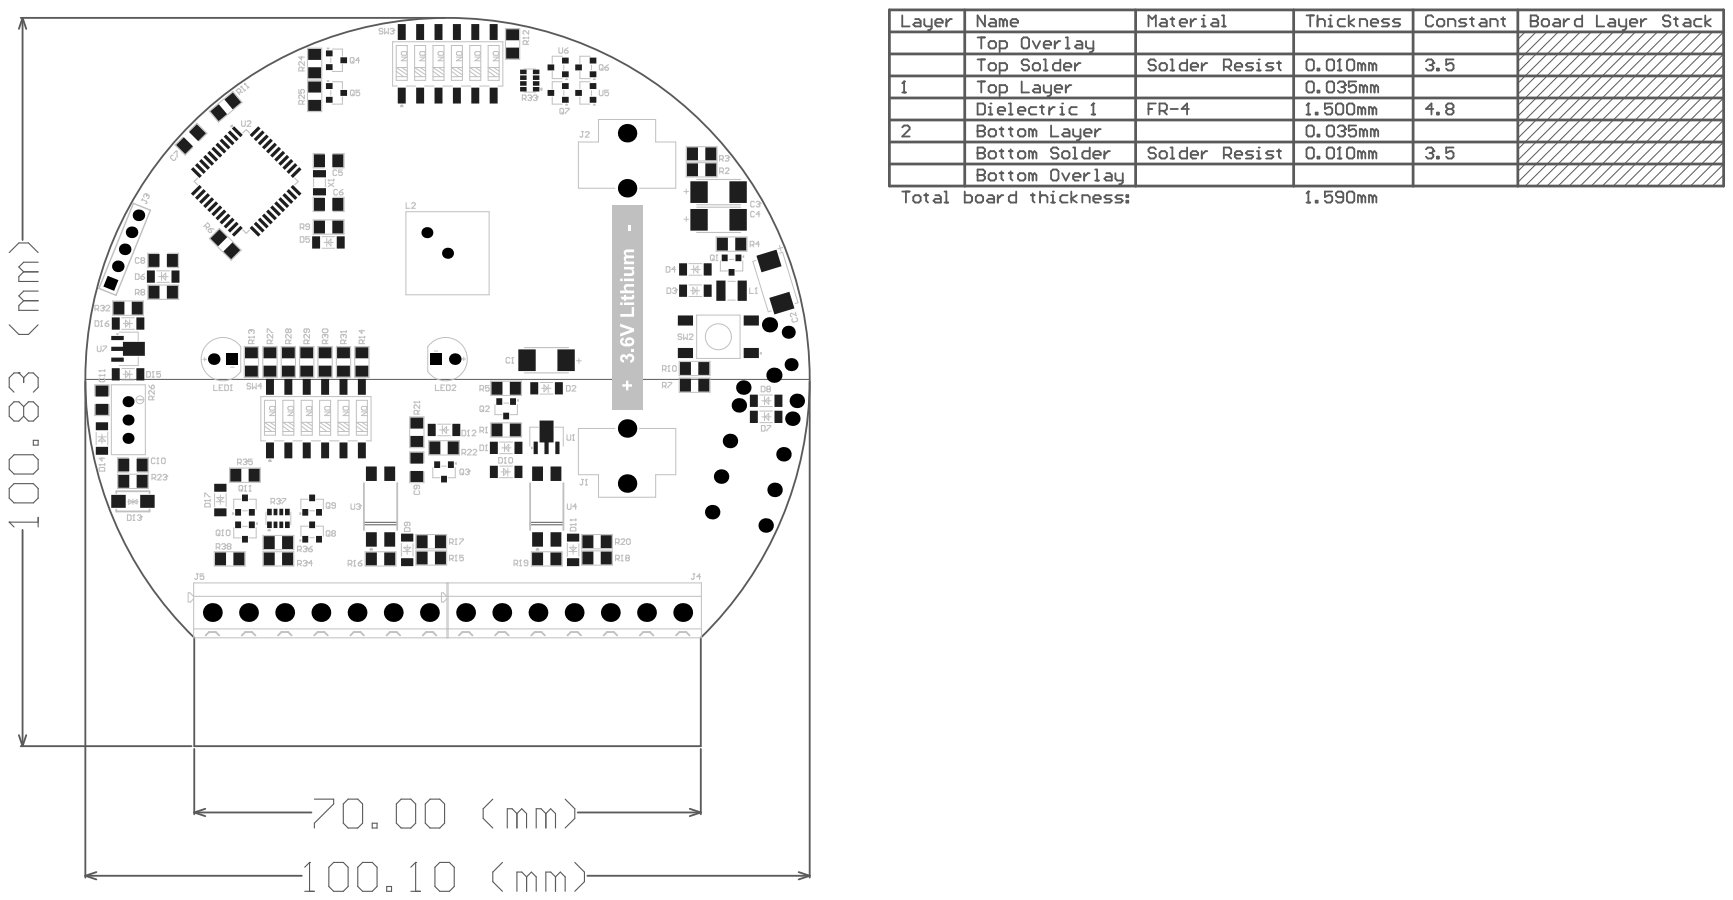
[picture p29: page 1]

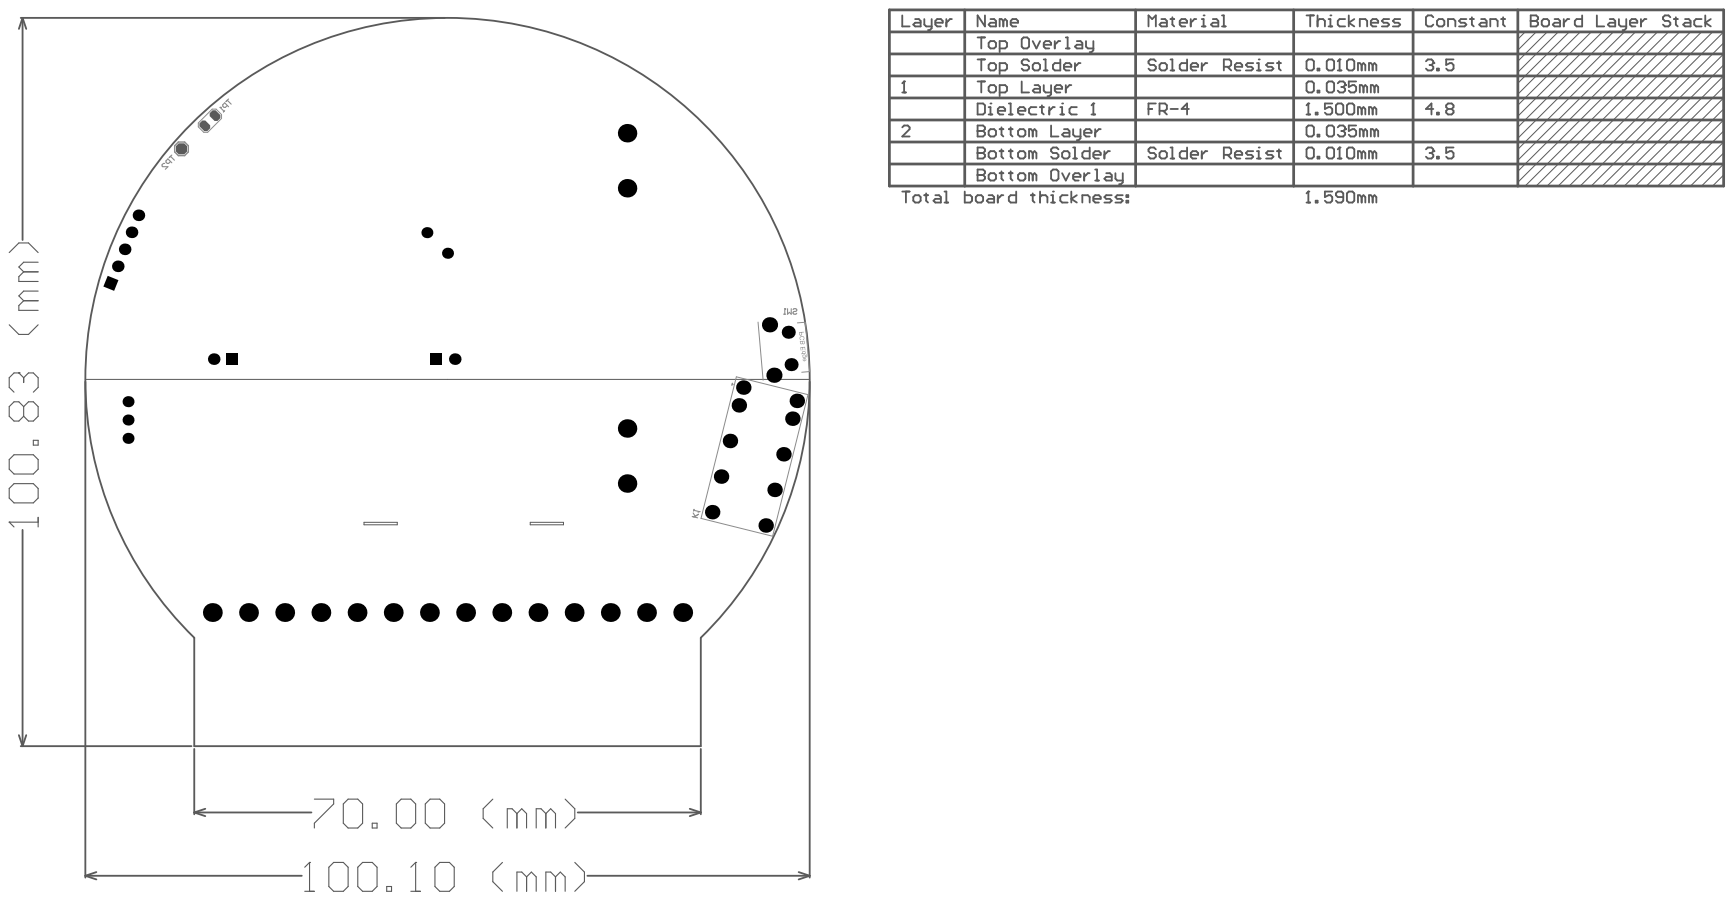
[picture p30: page 2]
