eSpark-Backup/nabilfesal-efi-hw/Design Files/EFI_Main_Board-V1.00/Deliverables/Assembly Drawings/EFI_Main_Board-V1.00.pdf

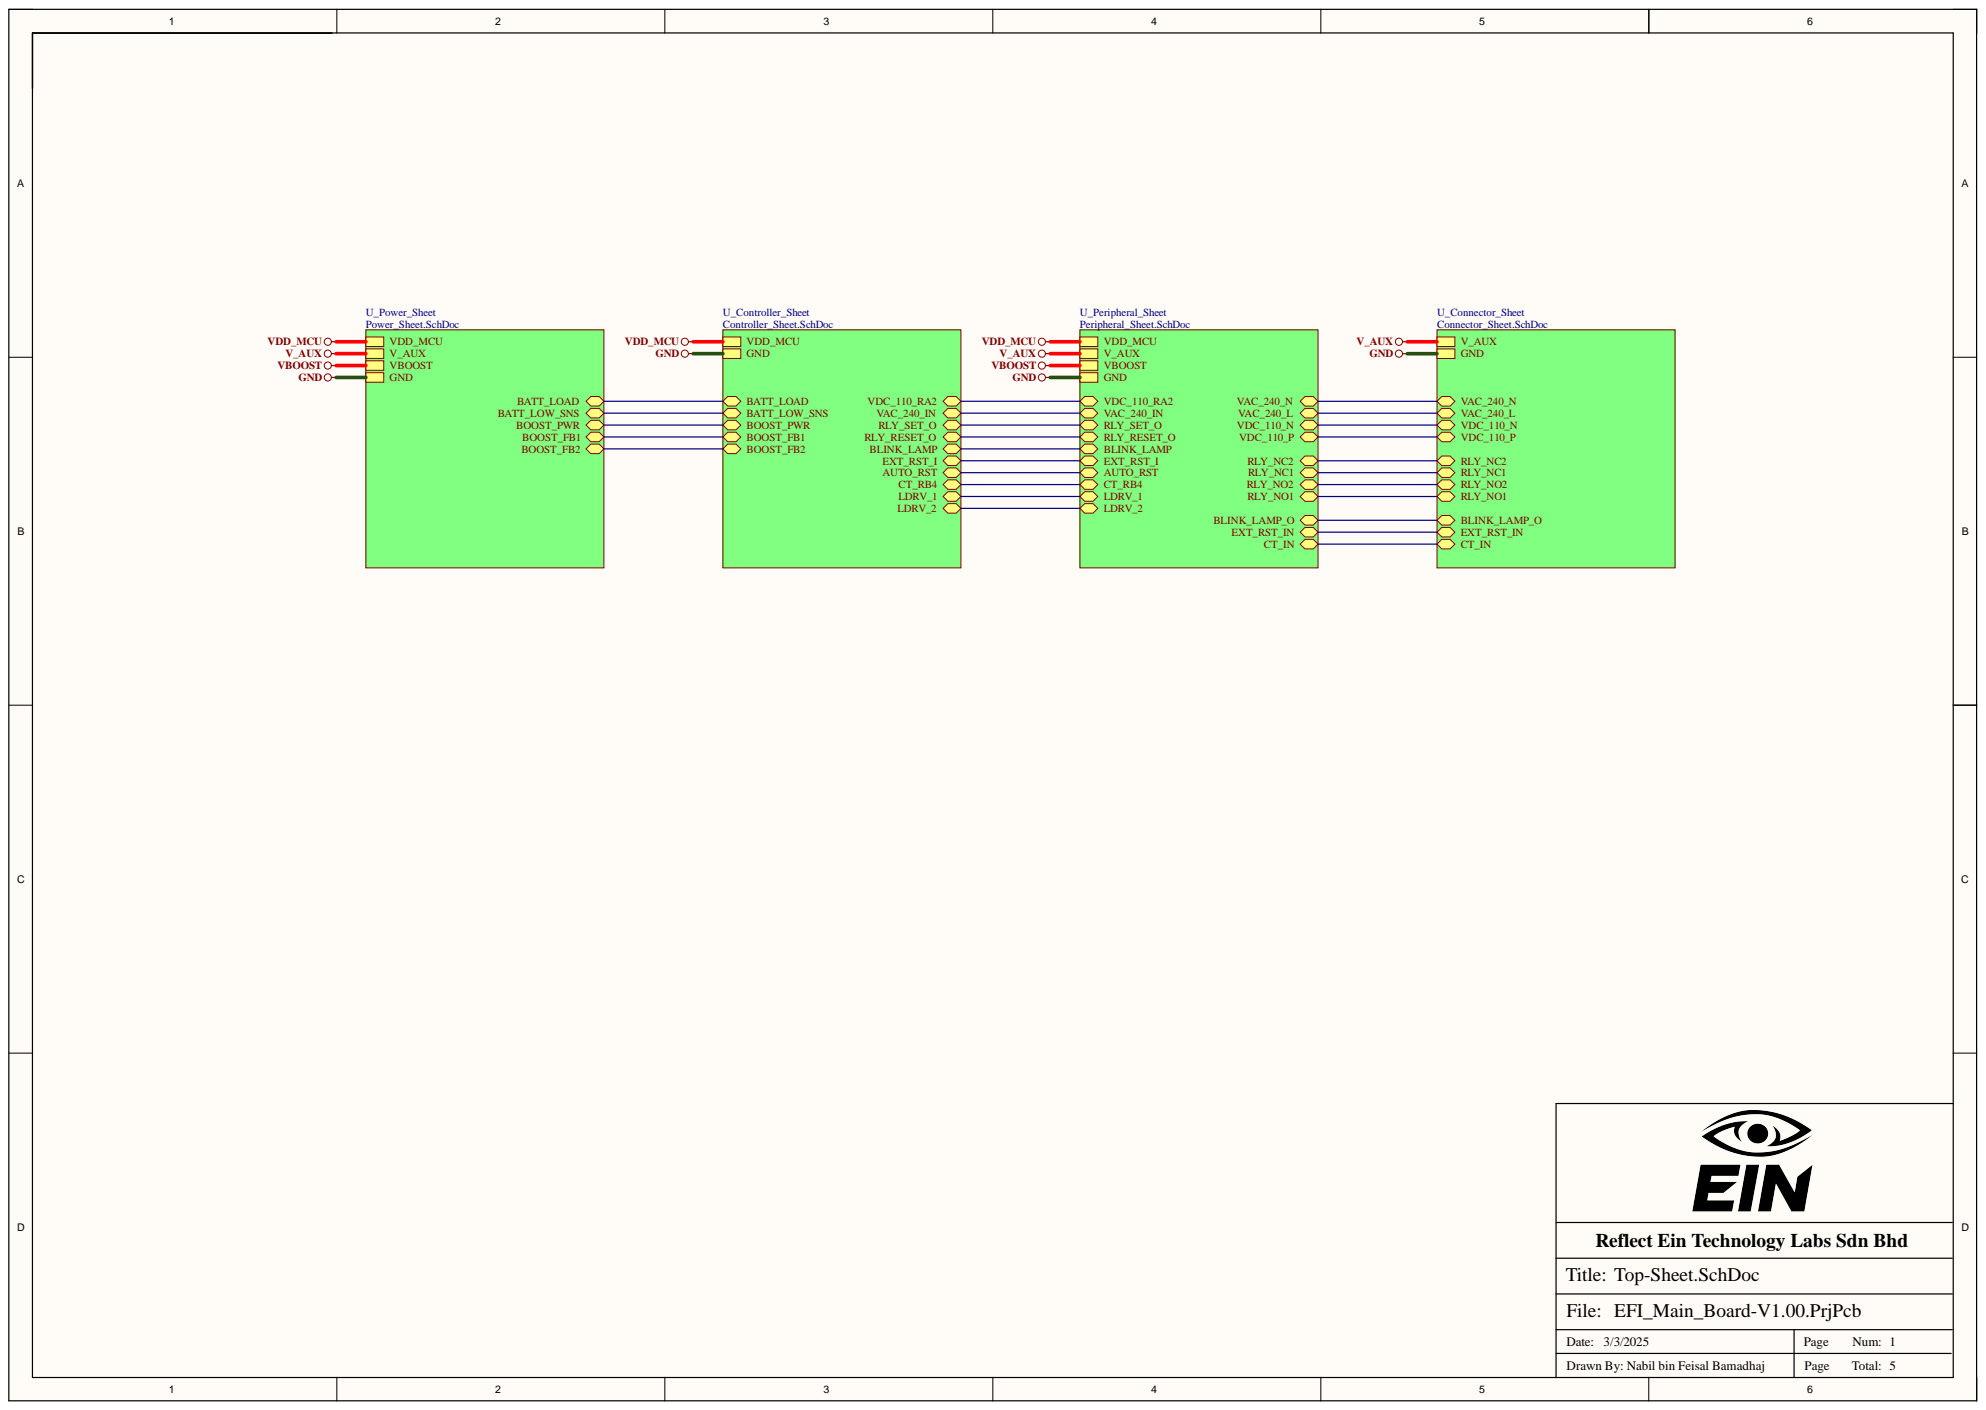
[picture p31: page 1]

Reflect Ein Technology Labs Sdn Bhd

Date: 3/3/2025 | Page Num: 1

Drawn By: Nabil bin Feisal Bamadhaj | Page Total:

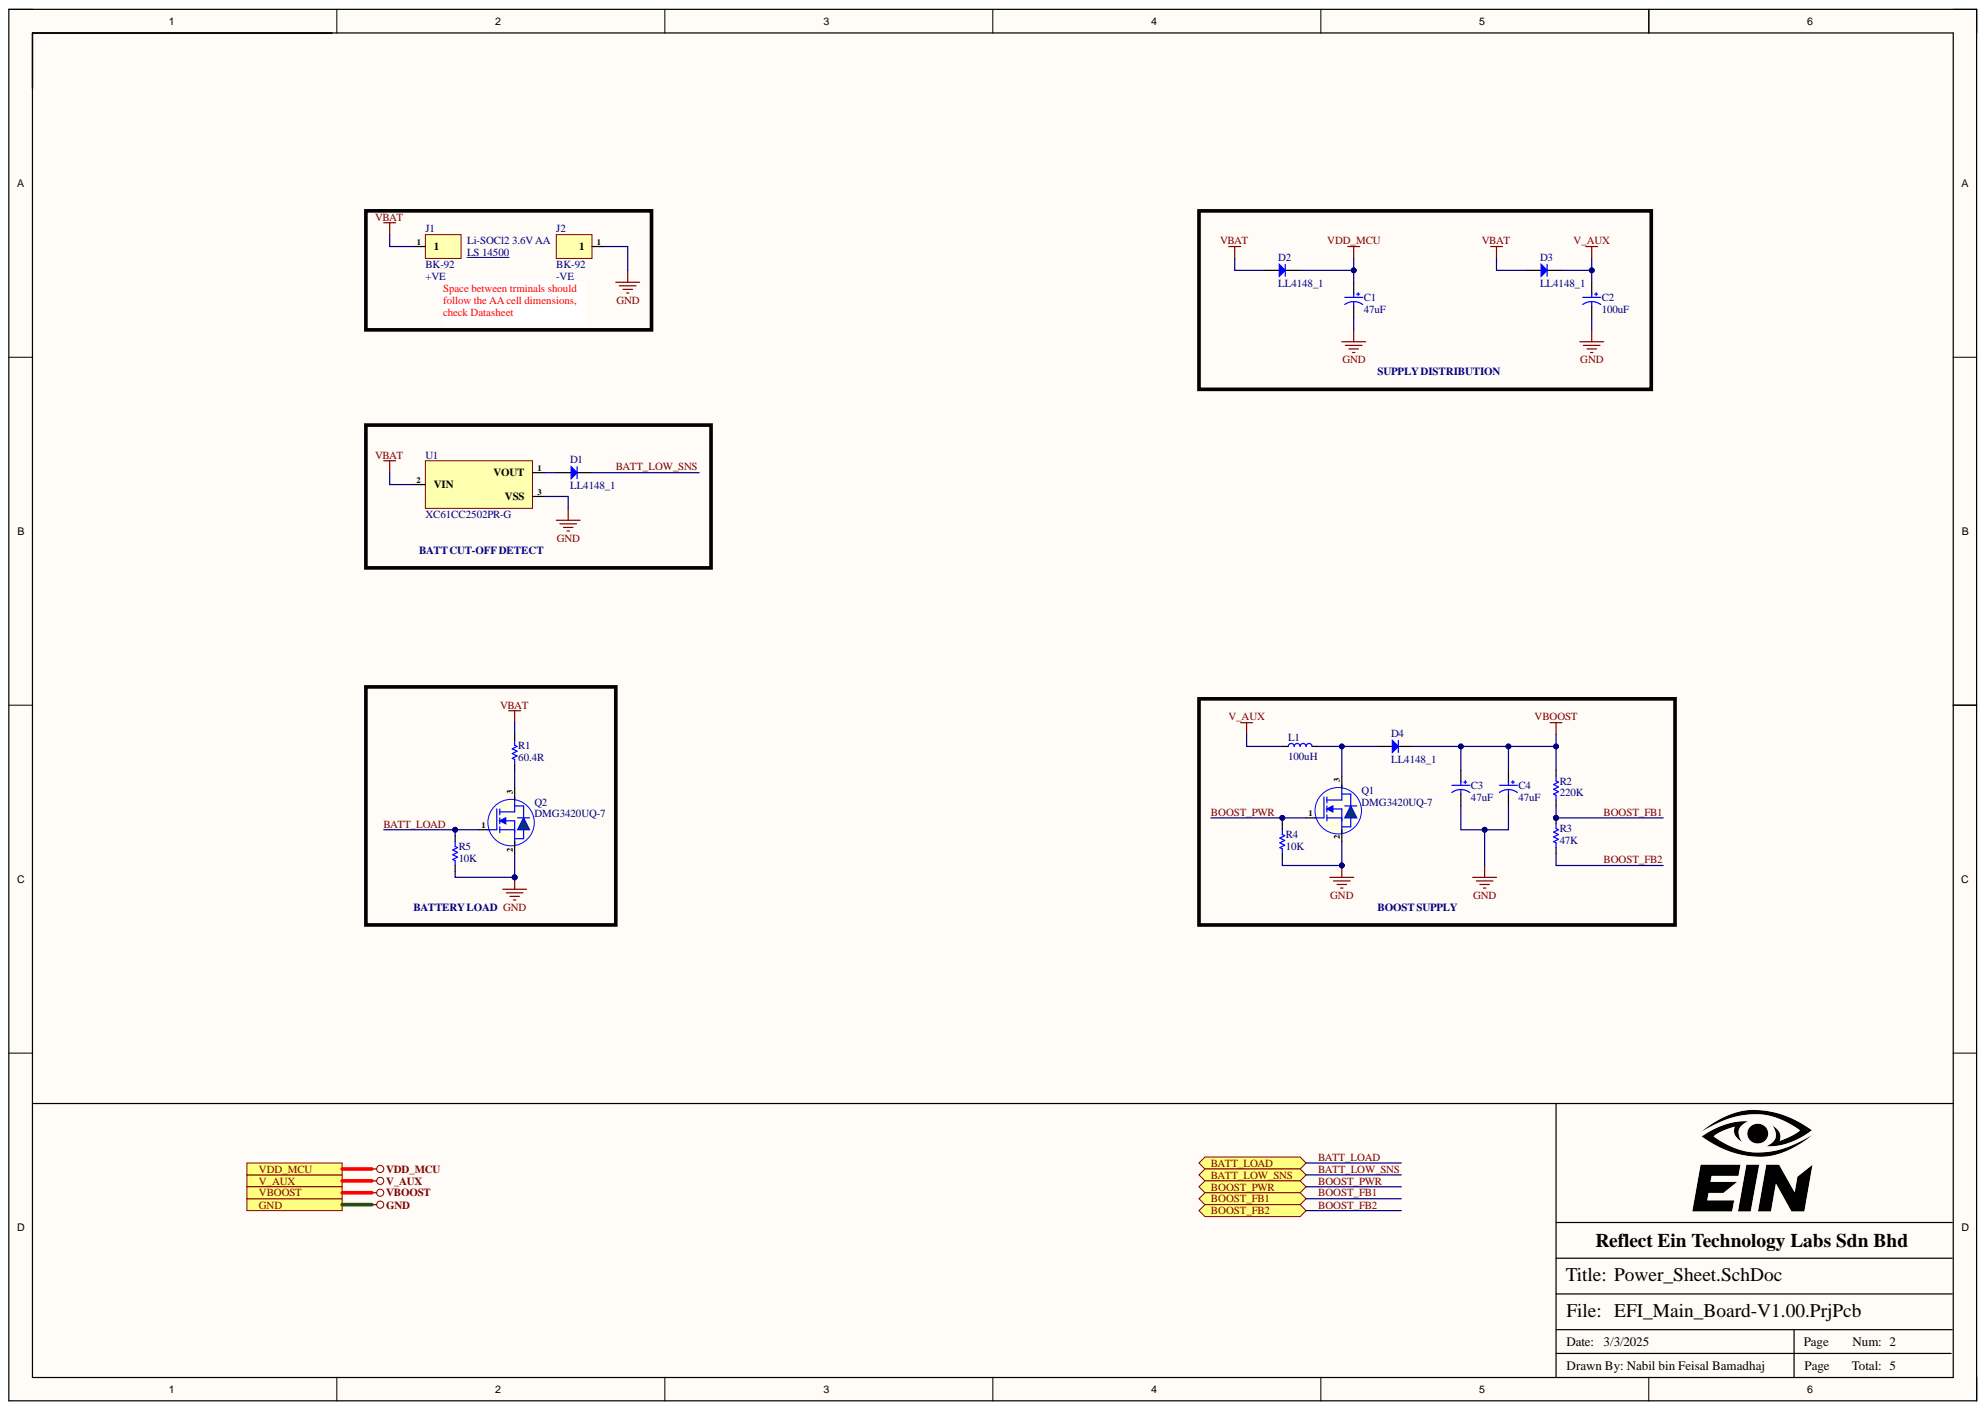
[picture p32: page 2]

Space between trminals should
follow the AA cell dimensions,
check Datasheet

BATT CUT-OFF DETECT

Reflect Ein Technology Labs Sdn Bhd

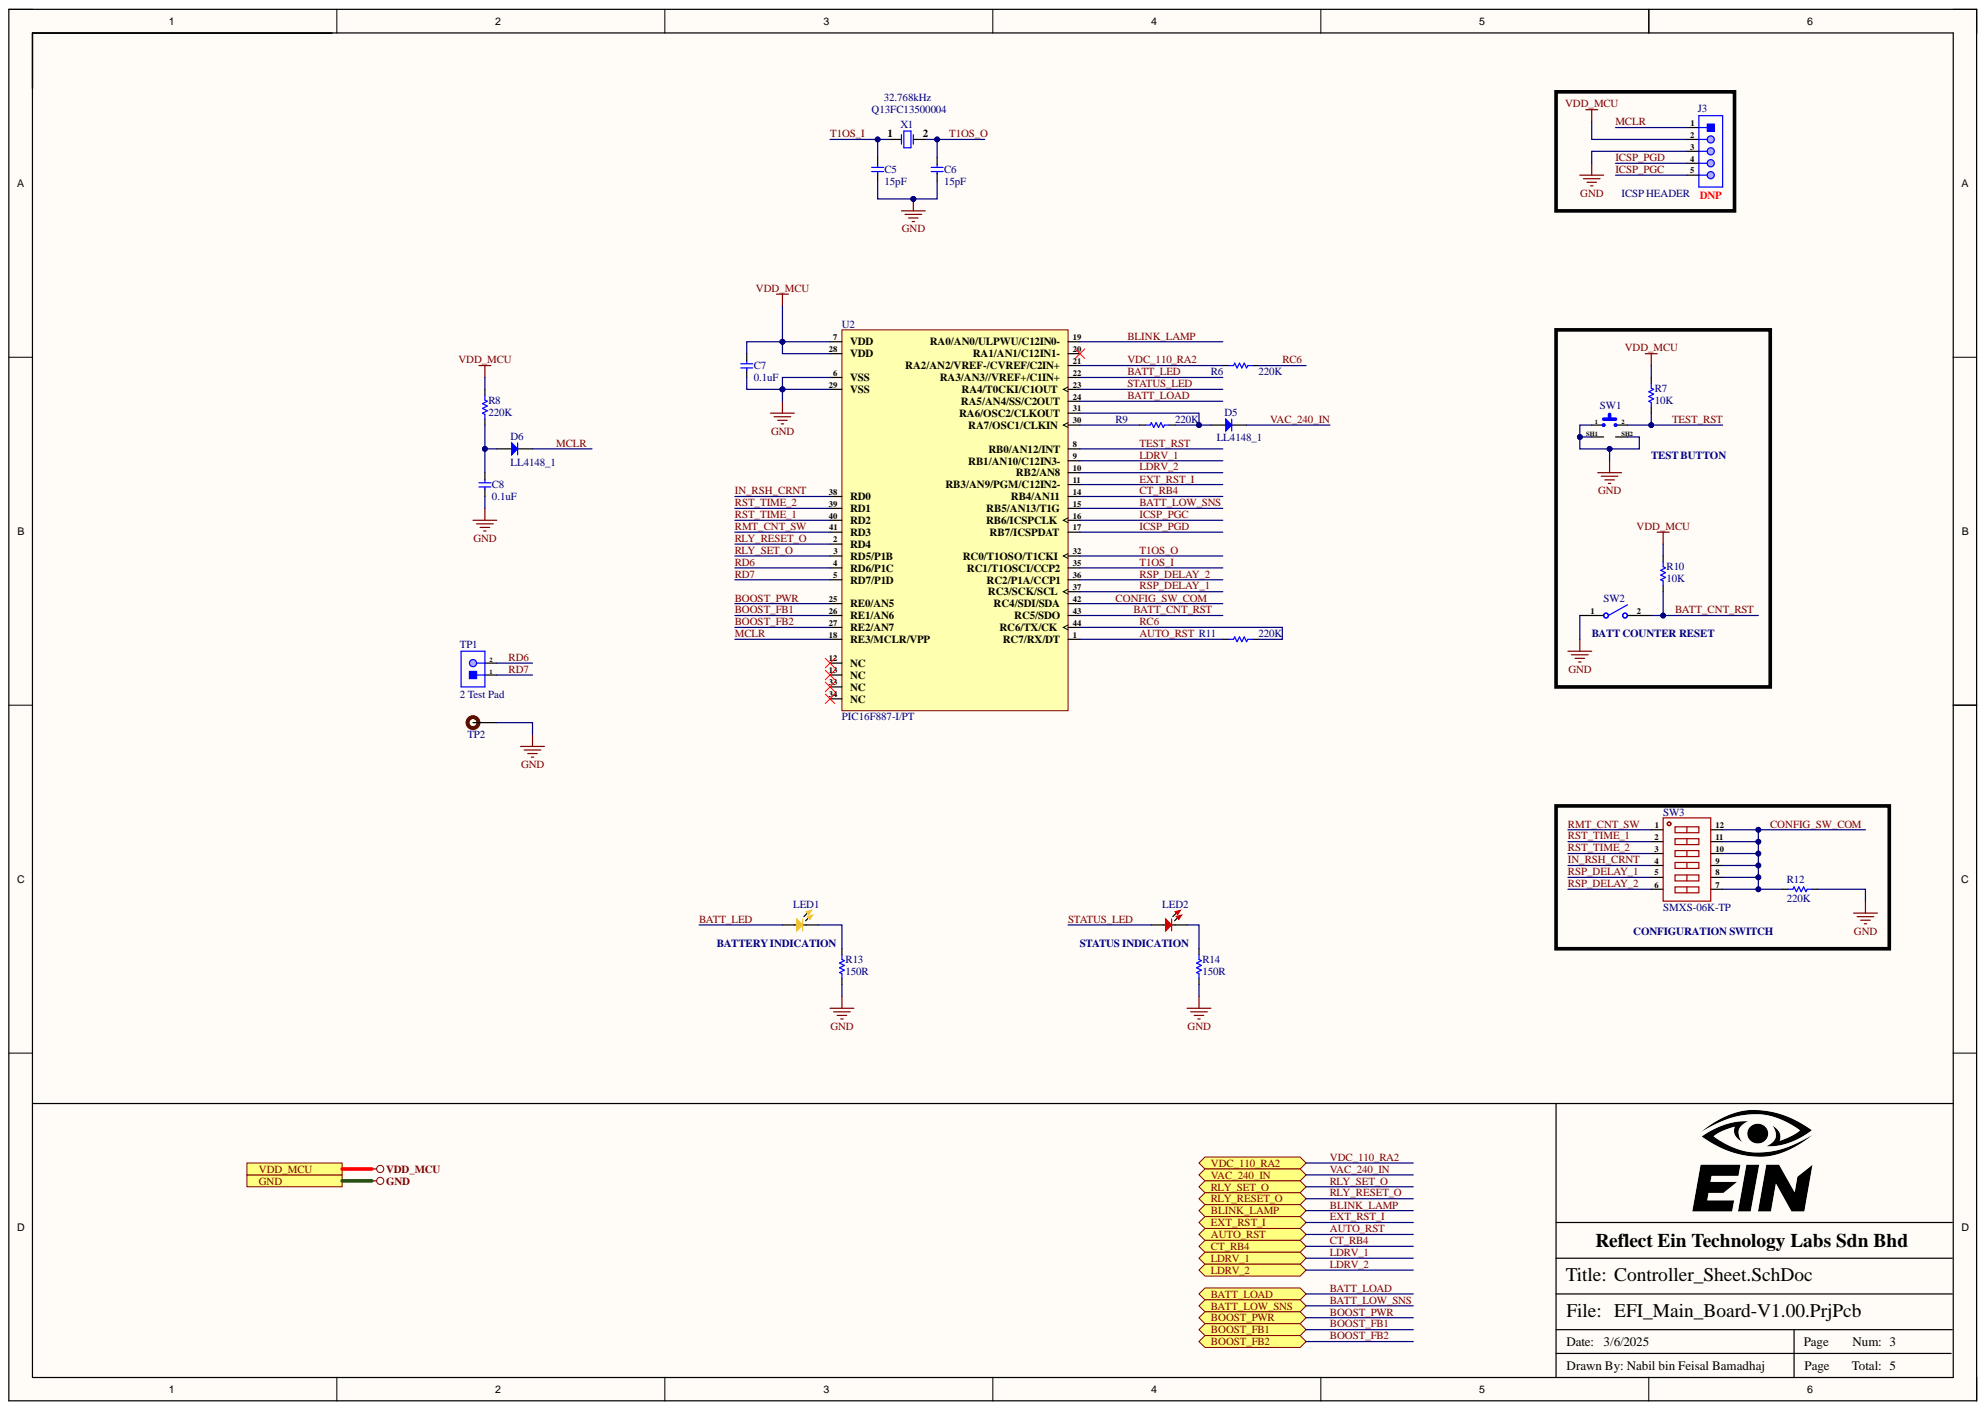
[picture p33: page 3]

Reflect Ein Technology Labs Sdn Bhd

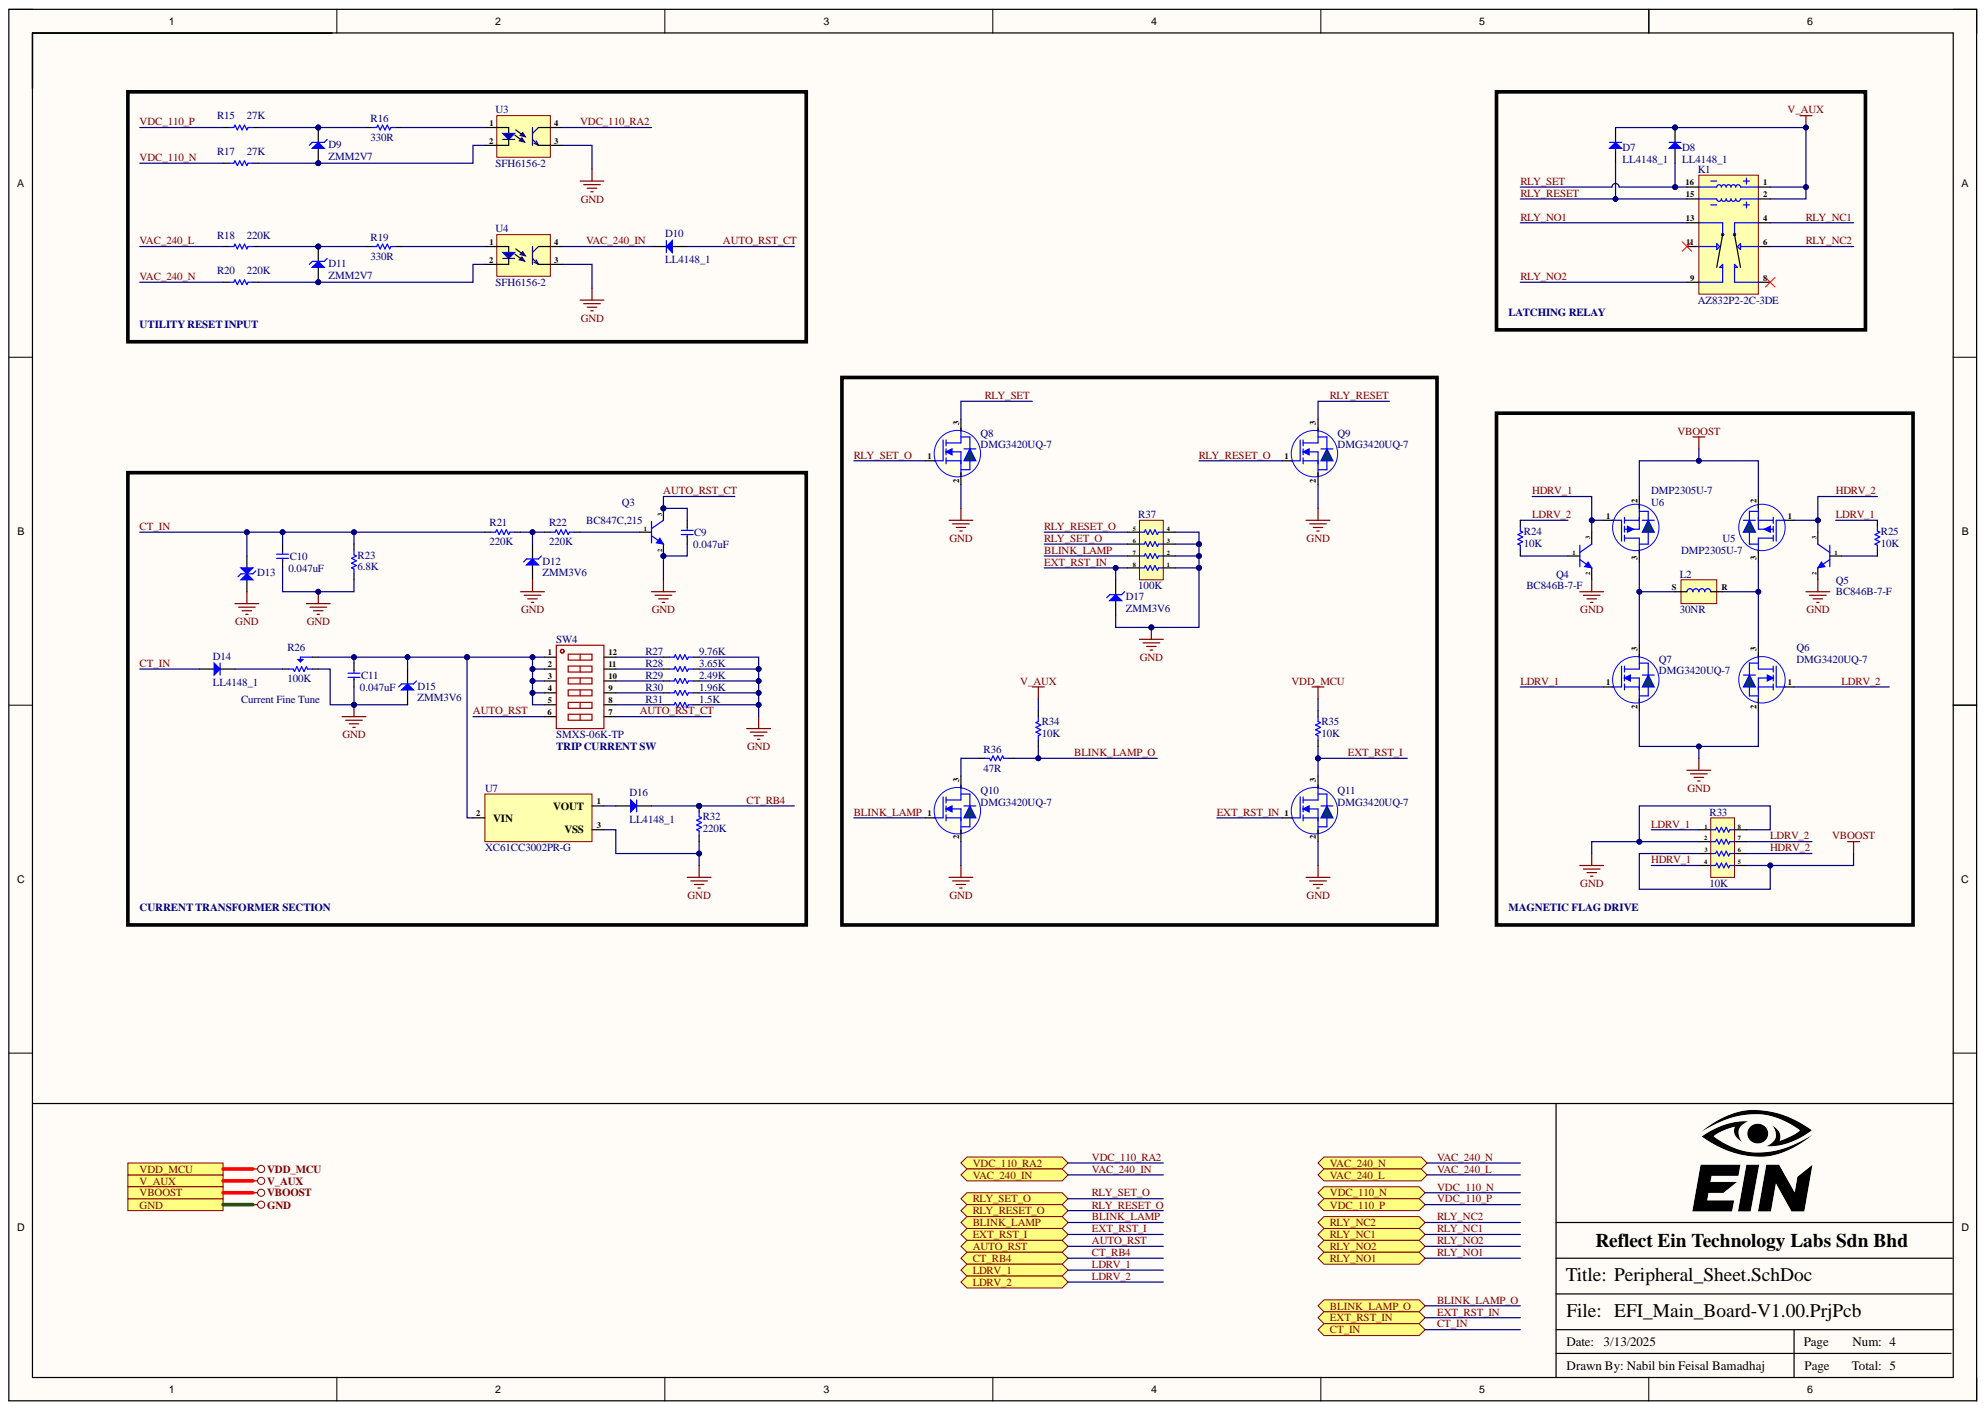
[picture p34: page 4]

Reflect Ein Technology Labs Sdn Bhd

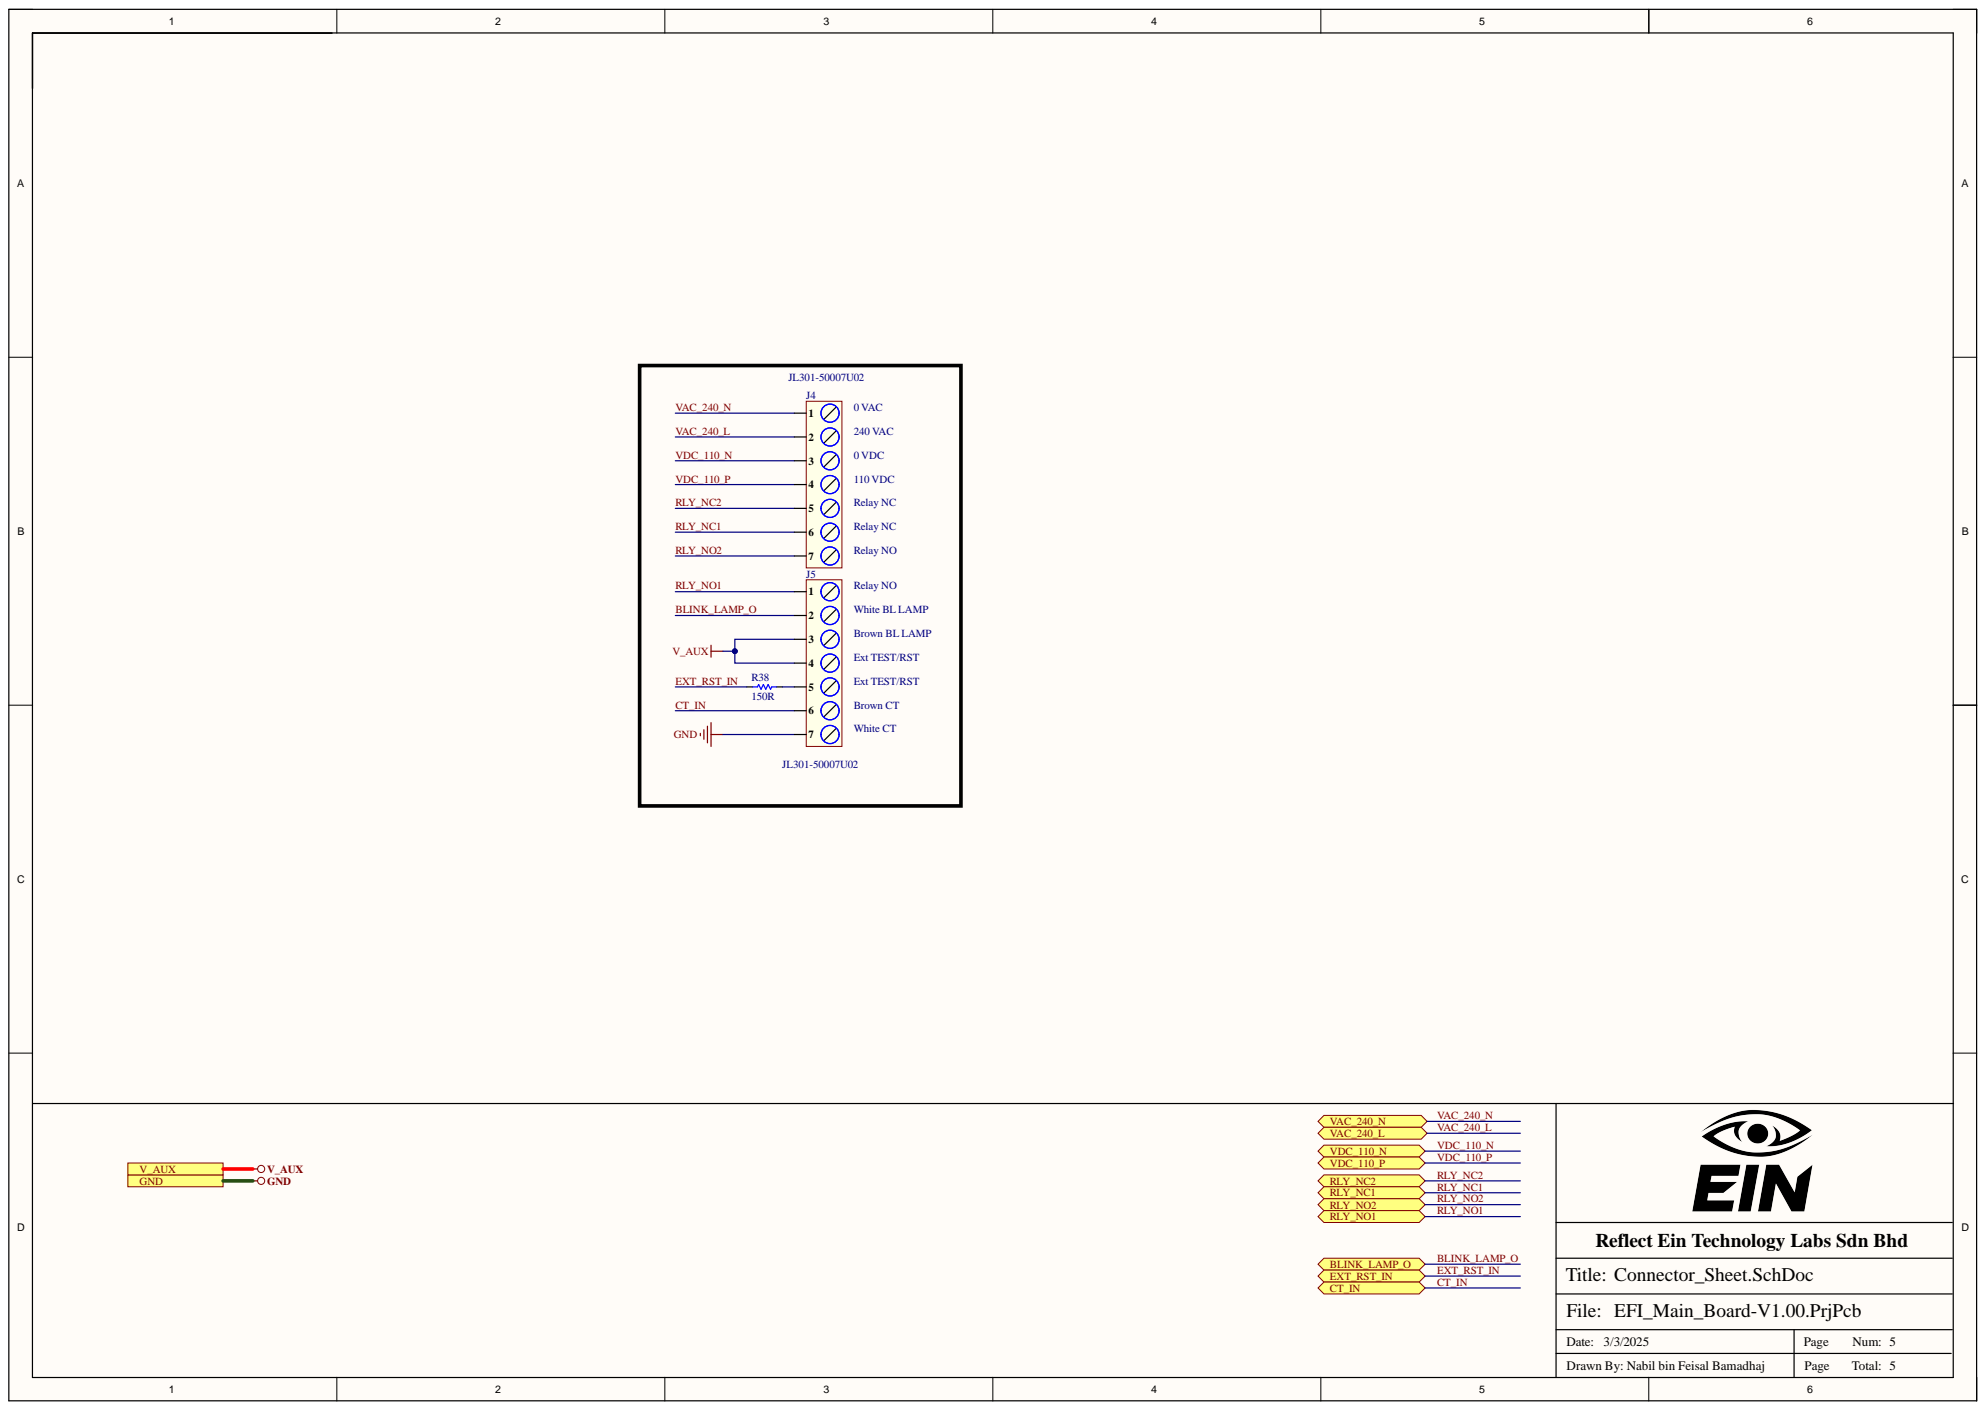
[picture p35: page 5]

Reflect Ein Technology Labs Sdn Bhd
