eSpark-Backup/nabilfesal-efi-hw/(list of files, drawings)

Other design files:
Design Files/EFI_Main_Board-V1.00/Controller_Sheet.SchDoc
Design Files/EFI_Main_Board-V1.00/EFI.PcbDoc
Design Files/EFI_Main_Board-V1.00/EFI_Main_Board-V1.00.PrjPcb
Design Files/EFI_Main_Board-V1.00/Peripheral_Sheet.SchDoc
Design Files/EFI_Main_Board-V1.10/Connector_Sheet.SchDoc
Design Files/EFI_Main_Board-V1.10/Controller_Sheet.SchDoc
Design Files/EFI_Main_Board-V1.10/EFI.PcbDoc
Design Files/EFI_Main_Board-V1.10/EFI_Main_Board-V1.10.PrjPcb
Design Files/EFI_Main_Board-V1.10/Peripheral_Sheet.SchDoc
Design Files/EFI_Main_Board-V1.10/Power_Sheet.SchDoc
Design Files/EFI_Main_Board-V1.10/Top-Sheet.SchDoc
