eSpark-Backup/nabilfesal-efi-hw/(commit log)

2025-01-31 #1 In Progress
    [CT_Sheet.SchDoc, Controller_Sheet.SchDoc, EFI_Main_Board-V1.00.PrjPcb, Power_Sheet.SchDoc]
2025-02-11 #1 Capacitors and Connector remaining
    [CT_Sheet.SchDoc, Controller_Sheet.SchDoc, Power_Sheet.SchDoc]
2025-02-13 #1 All sheets updated
    [CT_Sheet.SchDoc, Connector_Sheet.SchDoc, Controller_Sheet.SchDoc, EFI_Main_Board-V1.00.PrjPcb, Peripheral_Sheet.SchDoc, Power_Sheet.SchDoc, Top-Sheet.SchDoc]
2025-02-14 #1 PDF File generated
    [Power_Sheet.SchDoc]
2025-03-03 #1 L1 Inductor re-placed, had footprint issue.
    [Power_Sheet.SchDoc]
2025-03-03 #2 In-progress
    [EFI.PcbDoc, EFI_Main_Board-V1.00.PrjPcb]
2025-03-04 #1 J4 & J5 connector connections flipped. J3 marked as DNP
    [Connector_Sheet.SchDoc, Controller_Sheet.SchDoc]
2025-03-04 #2 Placement completed, client verification awaits.
    [EFI.PcbDoc]
2025-03-05 #1 Test Pads added
    [Controller_Sheet.SchDoc, EFI_Main_Board-V1.00.PrjPcb]
2025-03-06 #2 Routing completed, DRC and finishing remaining.
    [EFI.PcbDoc]
2025-03-07 #2 Design completed, flag indicator to be finalized.
    [EFI.DWG, EFI.DXF, EFI.PcbDoc, EFI.step, EFI_Main_Board-V1.00.PrjPcb]
2025-03-14 #1 Component "Flag indicator" re-placed in the SCH.
    [Peripheral_Sheet.SchDoc]
2025-03-14 #2 Design completed with updated Flag Indicator footprint and deliverables
    [Centroid.csv, EFI.DWG, EFI.DXF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]
2025-03-21 #2 Logo added in the PCB.
    [EFI.GBL, EFI.GBO, EFI.GBP, EFI.GBS, EFI.GKO, EFI.GTL, EFI.GTO, EFI.GTP]
2025-03-26 #3 Client BOM Added with Peripherals.
    [Client-BOM-EFI_Main_Board-V1.00.xlsx, Supplier BOM.xlsx]
2025-06-24 Prototype PCB pics added
2025-08-28 #4 SW2, LED2, L2 footprint updated. Relay & SW1 moved to TOP.
    PCB Mount holes changed 3.15mm
    [Client-BOM-EFI_Main_Board-V1.10.xlsx, Connector_Sheet.SchDoc, Controller_Sheet.SchDoc, EFI.DWG, EFI.DXF, EFI.PcbDoc, EFI.step, EFI_Main_Board-V1.10.PrjPcb]
2025-08-29 #4 SW2 moved 0.5mm to the left.
    [EFI.DWG, EFI.DXF, EFI.PcbDoc, EFI.step]
2025-10-16 Enclosure files pushed
    [Fault Indicator Ard - X Serial Numbers.xlsx, Fault Indicator Ard-X Required Modifications - Summary.xlsx, Fault Indicator Ard-X_22092025 3D CAD Model.STEP]
2025-11-13 #5 CT resistor network updated, Diodes updated
    [Controller_Sheet.SchDoc, Peripheral_Sheet.SchDoc, Power_Sheet.SchDoc]
2025-11-13 Latest Client BOM Updated.
    [Client-BOM-EFI_Main_Board-V1.10.xlsx, Client_BOM_EFI_Main_Board-V1.10.xlsx, Supplier BOM.xlsx]
